deklaus/OpenValveControl/Hardware/README.md

# This folder contains the schematics and hardware description

<table>
<tr>
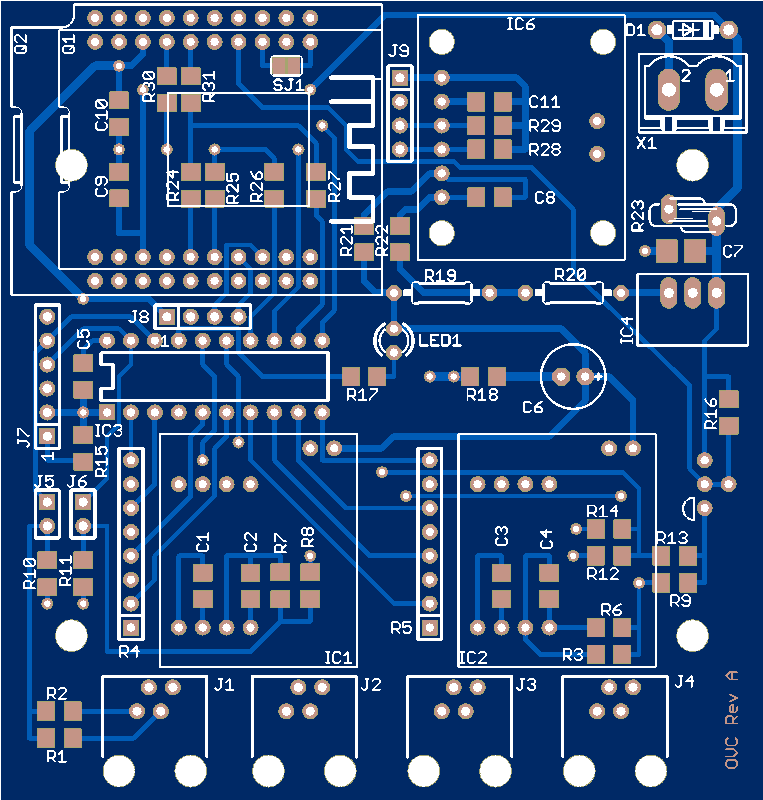
[picture p6: Hardware/ovc-A_preview_top.png]
PCB preview
  <td></td>
  <td>Assembly-2 Modules installed</td>
</tr>  
</table>

- [x] A working sample is running using a breadboard.
- [x] Layout and Gerber files are available.
- [x] PCBs available, built into housing, first desktop tests have passed.
- [x] Testing under real conditions (in progress).

## Block diagram
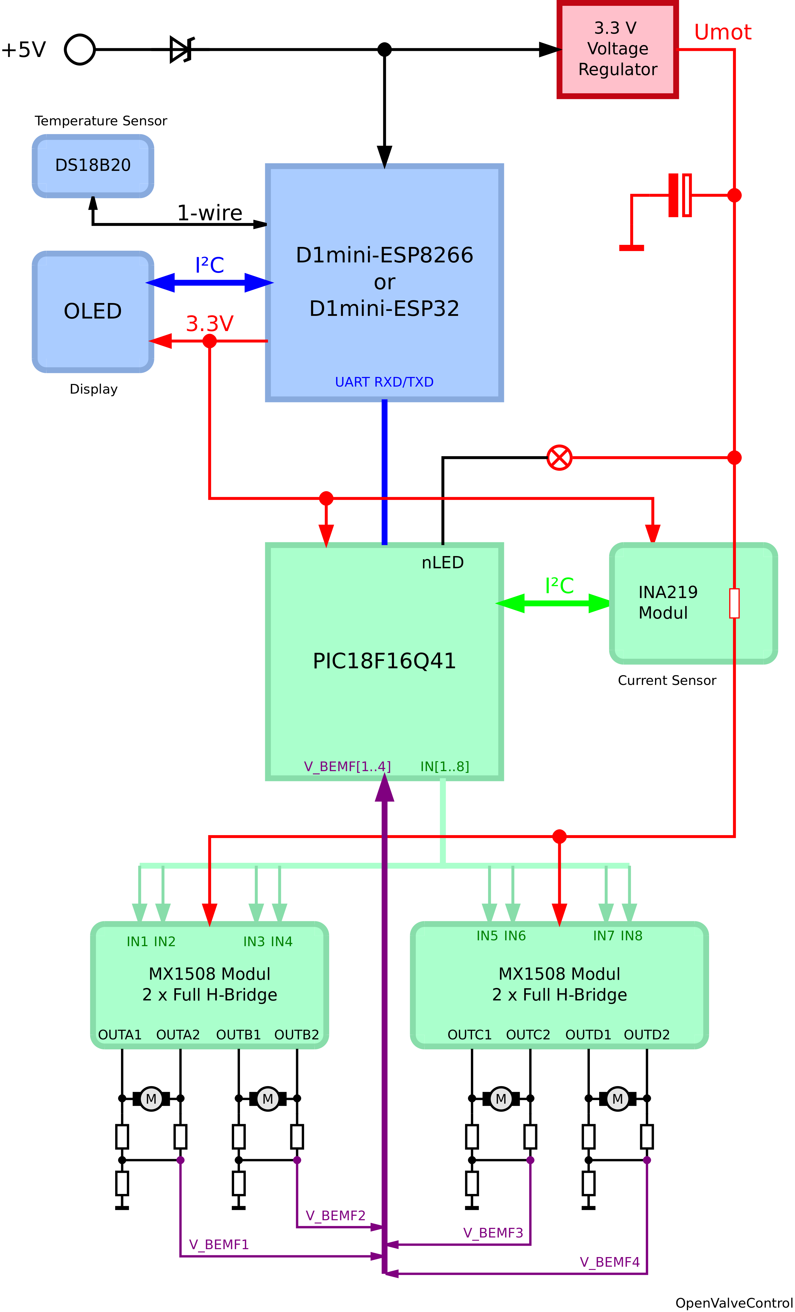
[picture p7: Photos/Block-Diagram.png]
Block-Diagram


## Schematics
- Schematics added as PDF

## Board and housing
- PCB design added as PDF
- PCB preview added
