deklaus/OpenValveControl/PIC-ValveControl/ValveControl.X/doxygen/html/init_8h_a348d23d5899ce59d18975284dfb0afc0_cgraph.png

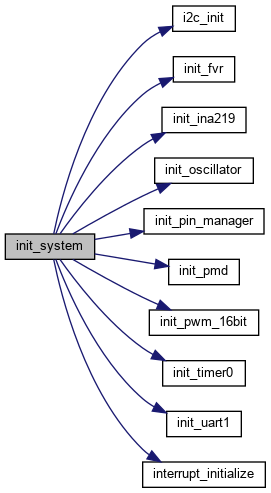
PIC-ValveControl/ValveControl.X/doxygen/html/init_8h_a348d23d5899ce59d18975284dfb0afc0_cgraph.png
