deklaus/OpenValveControl/Hardware/OpenValveControl_RevA_Schematics.pdf

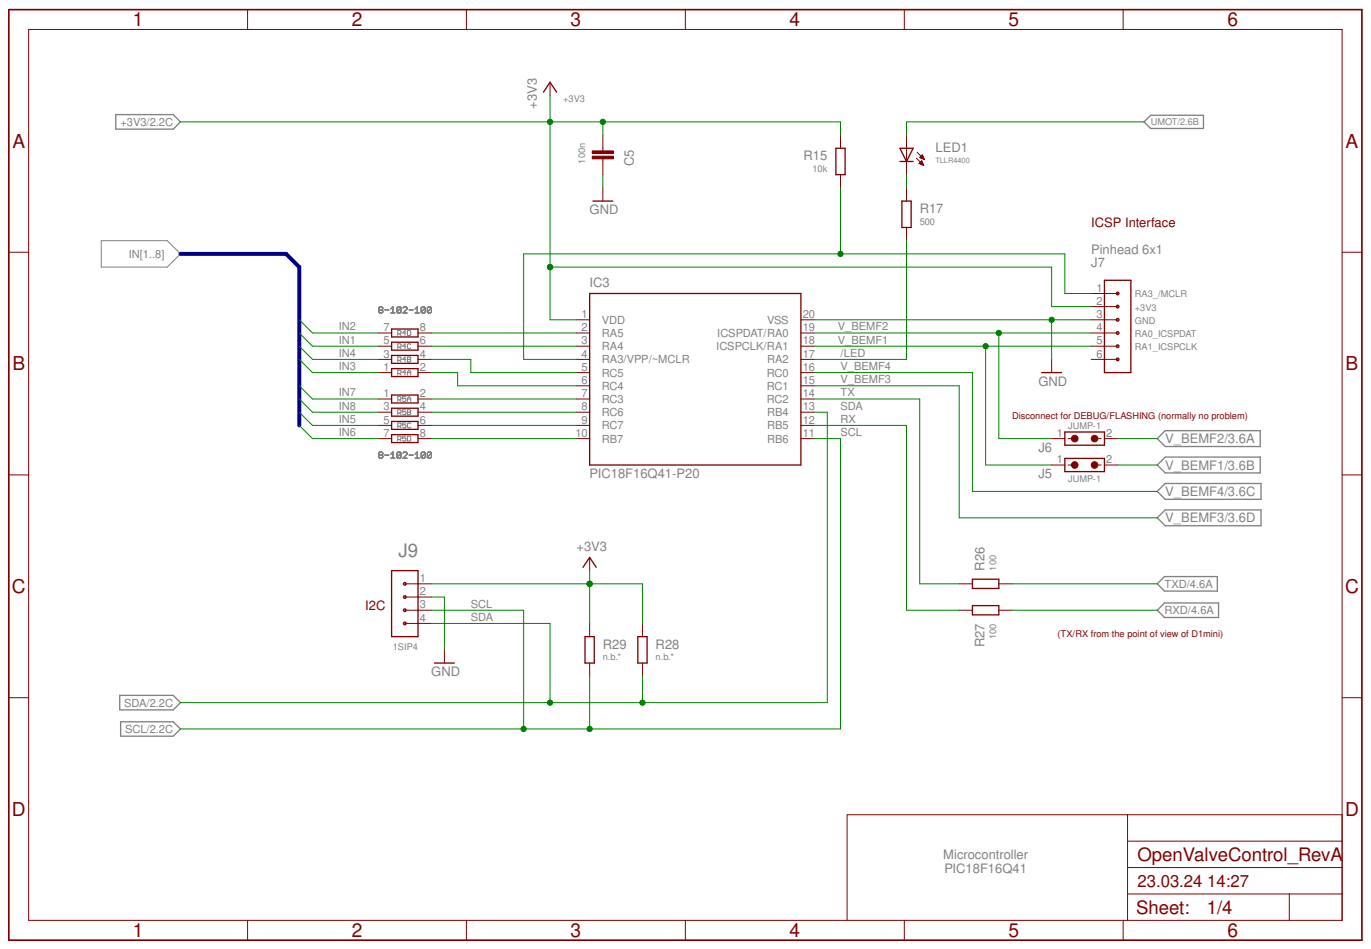
[picture p64: page 1]

Disconnect for DEBUG/FLASHING (normally no problem)

(TX/RX from the point of view of D1mini)

Microcontroller PIC18F16Q41

Sheet: 1/4

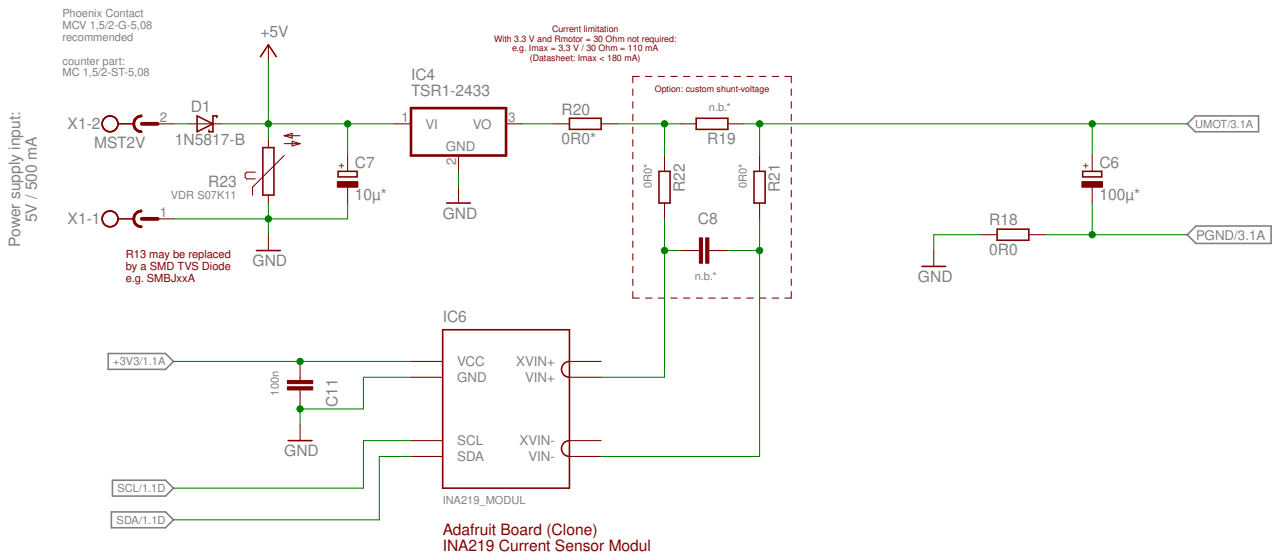
[picture p65: page 2]

Current limitation With 3.3 V and Rmotor = 30 Ohm not required: e.g. Imax = 3,3 V / 30 Ohm = 110 mA

counter part: MC 1,5/2-ST-5,08

Option: custom shunt-voltage

R13 may be replaced
by a SMD TVS Diode
e.g. SMBJxxA

Power Supply + Current Sense Modul INA219

Sheet: 2/4

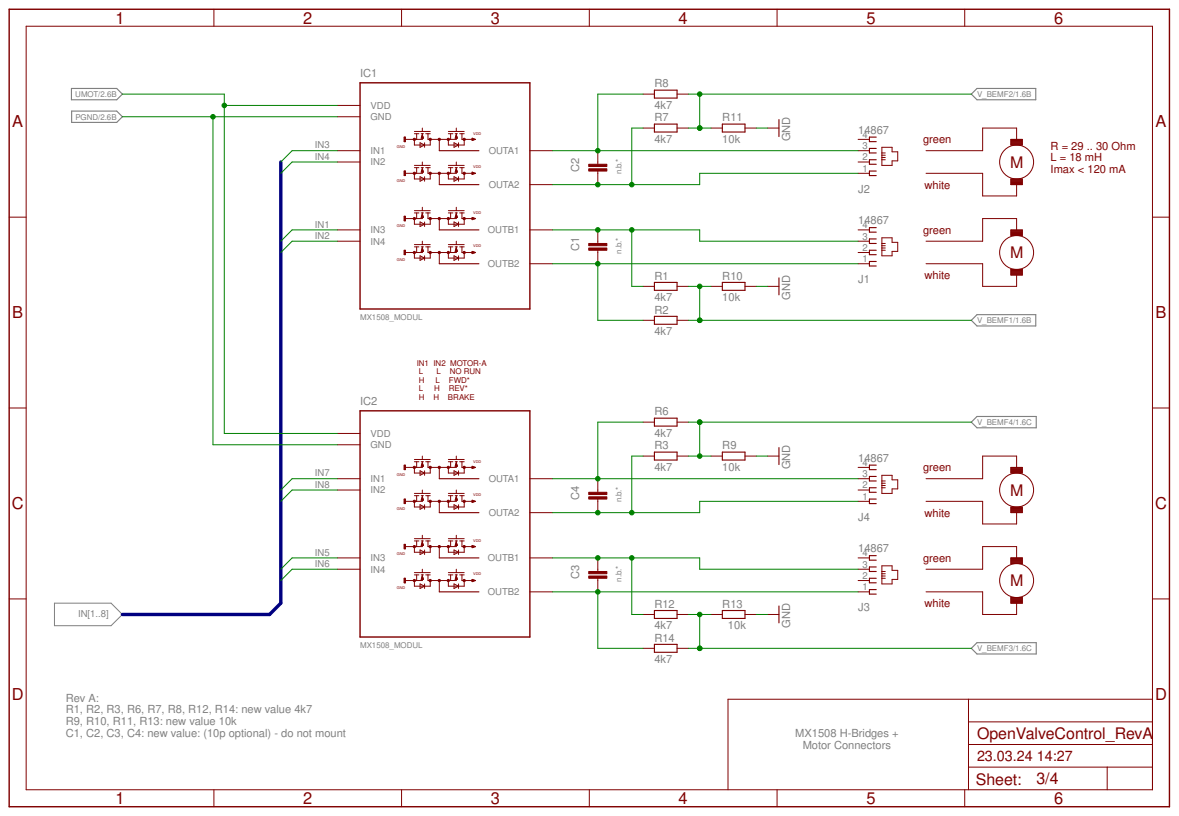
[picture p66: page 3]

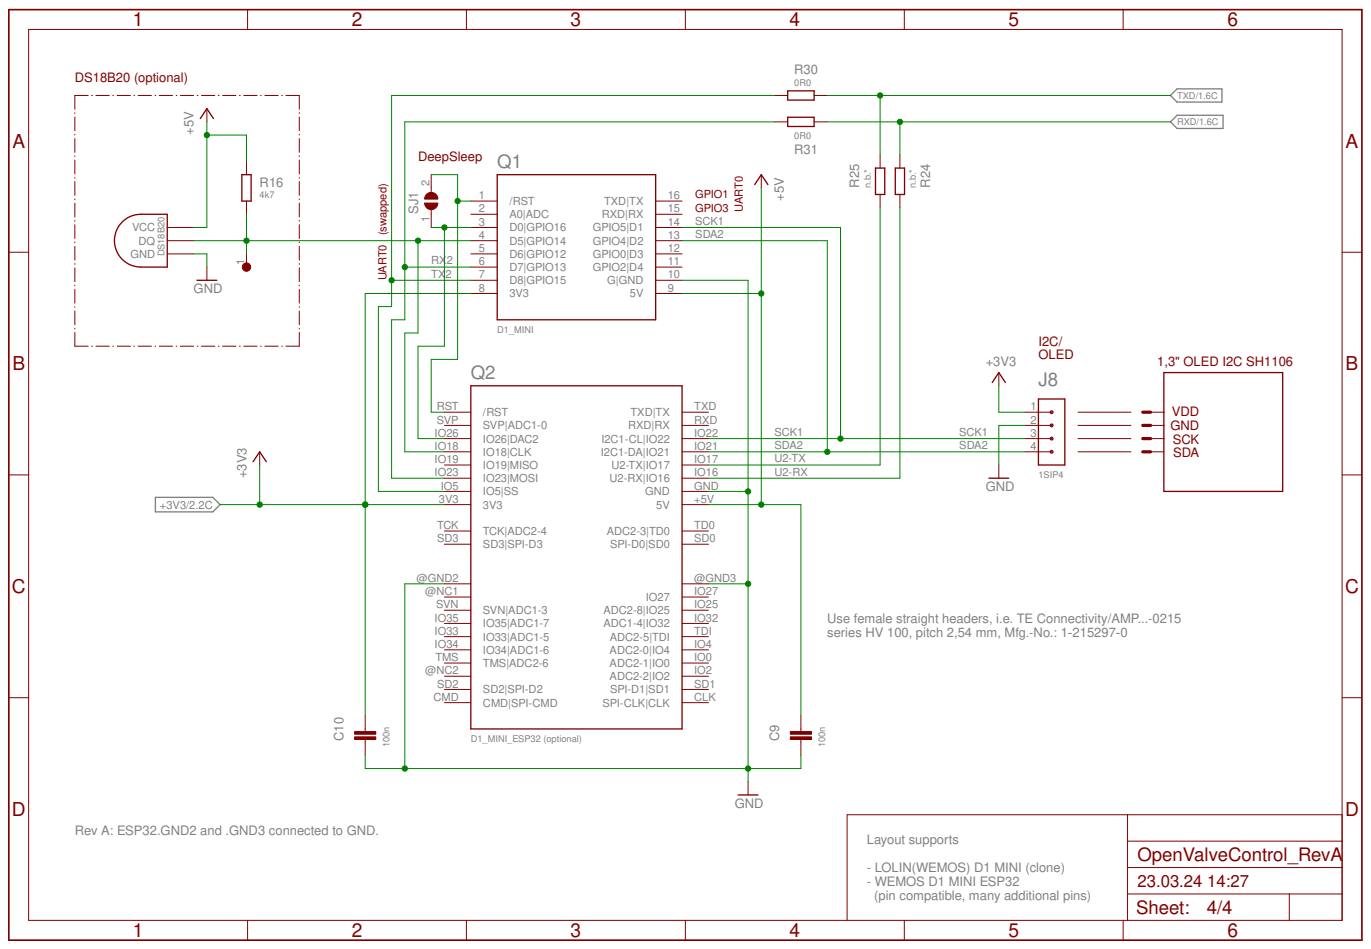
[picture p67: page 4]

7 | | 10 GPIO2|D4
8 | | 9 G|GND

Use female straight headers, i.e. TE Connectivity/AMP...-0215
series HV 100, pitch 2,54 mm, Mfg.-No.: 1‑215297‑0

Rev A: ESP32.GND2 and .GND3 connected to GND.

Layout supports - LOLIN(WEMOS) D1 MINI (clone) - WEMOS D1 MINI ESP32 (pin compatible, many additional pins)

Sheet: 4/4
