deklaus/OpenValveControl/Hardware/OpenValveControl_RevA_Board.pdf

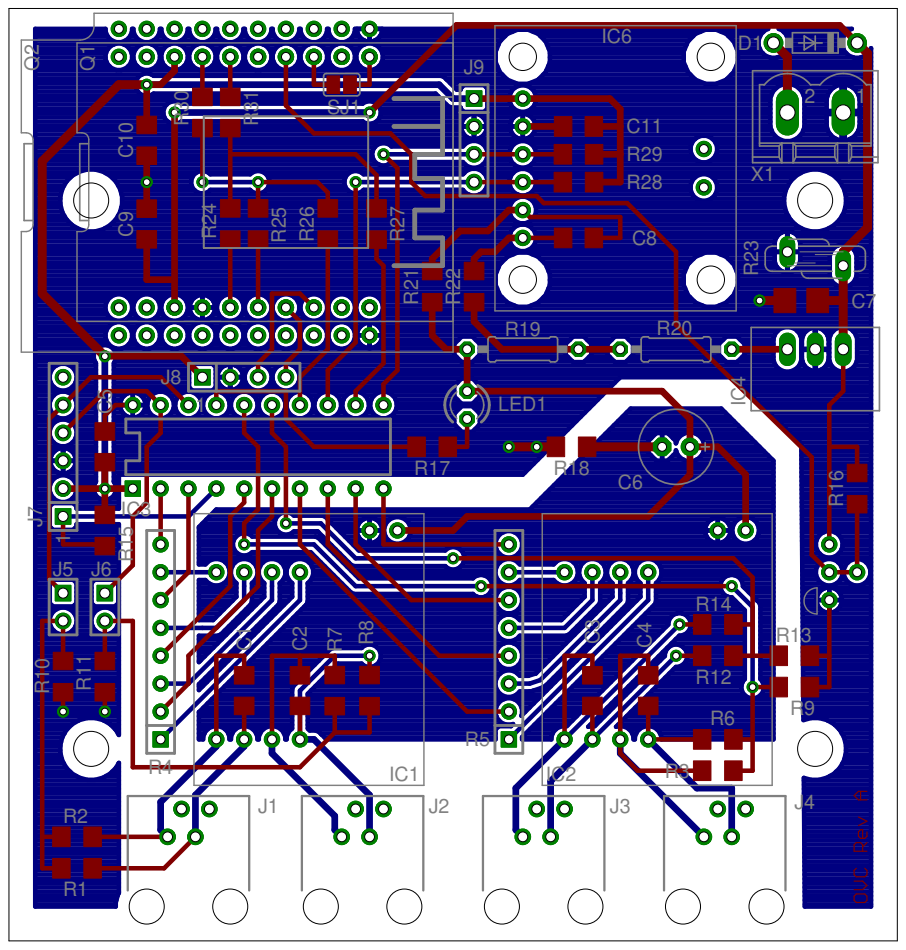
[picture p68: page 1]

C11
R29
R28 | X1
