deklaus/OpenValveControl/Hardware/OpenValveControl_RevA_Placeplan.pdf

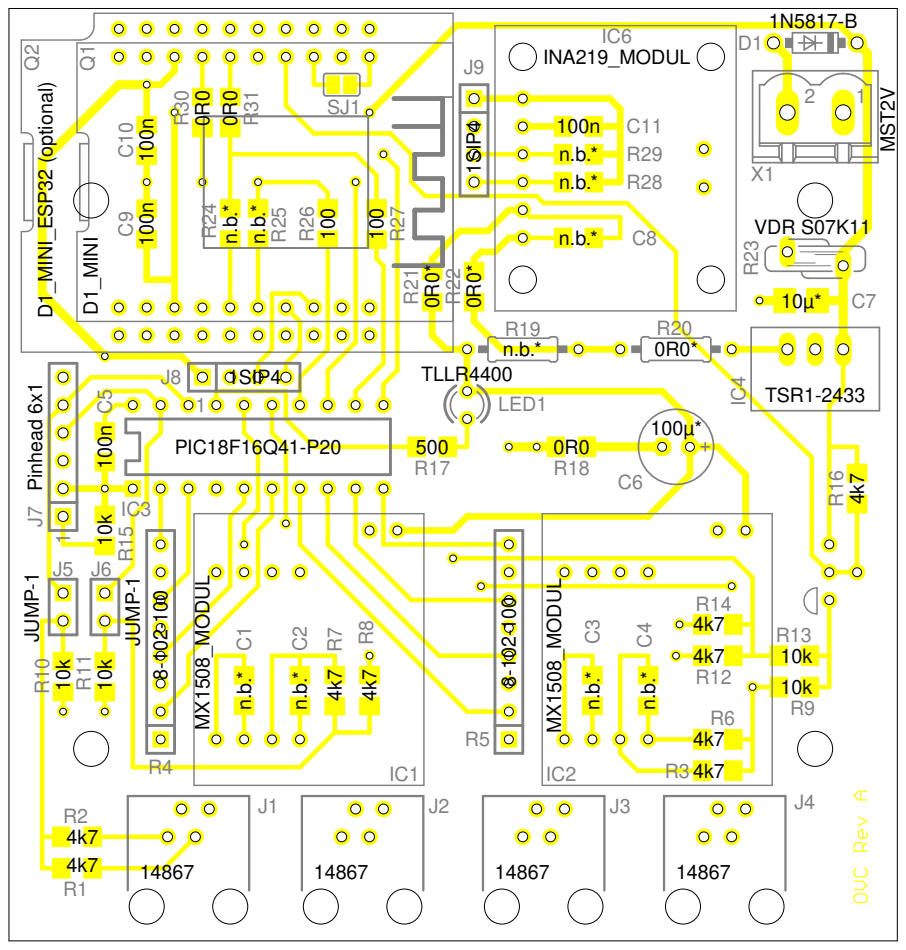
[picture p69: page 1]
