deklaus/OpenValveControl/ESP-ValveControl/ESP-ValveControl.ino

/** @file   ESPValveControl.ino
 *  @author  (c) Klaus Deutschkämer (https://github.com/deklaus)
 *  License: This software is licensed under the European Union Public Licence EUPL-1.2
 *           (see https://joinup.ec.europa.eu/collection/eupl/eupl-text-eupl-12 for details).
 *
 *  @brief  WiFi-Interface for OpenValveControl (PIC-)Controller.
 *  \b Functions:
 *   - Display all 4 valve positions
 *   - Display motor current
 *   - Selection of a distribution zone (VZ)
 *   - Input of max. current for MOVE or HOME
 *   - Triggering a MOVE (VZ) to desired position
 *   - Triggering a reference run (HOME)
 *   - Temperature measurement with DS18B20
 *   - Status display, p.e. positions, firmware (ESP and PIC), WiFi,...
 *   - Access point (until local WiFi has been configured)
 *   - OTA Firmware-Update ESP
 *   - Write to PIC EEPROM via Web UI
 *   - Firmware-Update (PIC) via Web UI
 *
 *  \b IDE: <c> Arduino IDE 2.2.1 &rarr; <c> esptool.py v3.0 \n
 *  \b Device: \n
 *     - <c> LOLIN(WEMOS) D1  mini (clone) </c> (current state)
 *     - <c> <b> WEMOS D1 mini ESP32 <\b></c>   (optional) \n
 *  \b Libs: \n
 *     - <c> ESP8266WiFi              Version 1.0     path: ~/.arduino15/packages/esp8266/hardware/esp8266/3.1.2/libraries/ESP8266WiFi </c>
 *     - <c> ESP8266WebServer         Version 1.0     path: ~/.arduino15/packages/esp8266/hardware/esp8266/3.1.2/libraries/ESP8266WebServer </c>
 *     - <c> ESP8266HTTPUpdateServer  Version 1.0     path: ~/.arduino15/packages/esp8266/hardware/esp8266/3.1.2/libraries/ESP8266HTTPUpdateServer </c>
 *     - <c> PubSubClient             Version 2.8     path: ~/Arduino/libraries/PubSubClient </c>
 *     - <c> ArduinoJson              Version 6.21.4  path: ~/Arduino/libraries/ArduinoJson </c>
 *     - <c> LittleFS                 Version 0.1.0   path: ~/.arduino15/packages/esp8266/hardware/esp8266/3.1.2/libraries/LittleFS </c>
 *     - <c> DallasTemperature        Version 3.9.0   path: ~/Arduino/libraries/DallasTemperature </c>
 *     - <c> MAX31850 OneWire         Version 1.1.3   path: ~/Arduino/libraries/MAX31850_OneWire </c>
 *     - <c> U8g2                     Version 2.34.22 path: ~/Arduino/libraries/U8g2 </c> or
 *     - <c> SPI                      Version 1.0     path: ~/.arduino15/packages/esp8266/hardware/esp8266/3.1.2/libraries/SPI </c>
 *     - <c> Wire                     Version 1.0     path: ~/.arduino15/packages/esp8266/hardware/esp8266/3.1.2/libraries/Wire </c>
 *  \n
 *  Weblinks: \n
 *  Doxygen:    https://www.doxygen.nl/manual/docblocks.html \n
 * 
 * Change Log:
 * 2024-09-24 v0.9
 * - Added new command: EEwrite EEwrite:<uint16 addr,uint16 data>
 *   This command allows to change PIC EEPROM, p.e. VBSUM_1pct @EEPROM addr = 2. 
 * - Error codes PICerrno and ESPerrno are exported with status report and are shown in Web-UI v0.9 and above.
 *   Corresponding text messages may be edited in customize.js.
 * - Read access to all files except index.html was restricted to private IP addresses Class C (192.168.x.x).
 * 2024-03-11 v0.8
 * - Added data logger: <IP>/logdata? reads curr_log[] and bemf_log[] from PIC.
 * - Added VBsum to "info?" for testing BEMF sum-up for position control.
 * 2024-01-29 v0.7.1
 * - Processing of flags.version moved to the end of "else-if". (A failed bootload could not be 
 *   repeated, because the initialized "flags.version" always took priority and never was worked off.
 * 2024-01-24 v0.7
 * - Added 'MQTT publish' with status information (motor current, temperature, positions, etc.)
 * - Added WiFI signal strength to "Info"
 *   omitted double quotes around integers and floats in JSON output.
 * - added script customize.js:
 *    This script must be uploaded into the ESP filesystem with the given name. 
 *    The function CustomizeLabels() optionally replaces some default headers 
 *    and labels by your own texts, which can be changed in the script.
 *    The script is read at the end of <head>, but the function must 
 *    only be called once at the end of <body>, when the complete HTML document 
 *    has been read by the browser.
 *    The main advantage is that your room descriptors are retained even if the 
 *    original index.html is updated.
 *    The script also can be extended by your own instructions.
 * 2023-12-01 v0.6.1
 * - Status now reflects status from PIC (set_pos[], max_mA[] and refset[]).
 * 2023-11-15 v0.6
 * - Added acces point mode (OVC-access-point/PVC-password).
 * - Reading and writing of setup file "ovc.ini". LittleFS.ini supplemented with proper mime/ContentType.
 * v0.5 Test version
 * 2023-11-12 v0.4
 * - Added OTA support. Enter URI/update to select and upload new firmware binary file (.bin).
 * 2023-11-07 v0.3
 * - Added LittleFS. Web-UI must now be uploaded as separate file (index.html) via LittleFS (URI/fs.html)
 *   Requires Web-UI (index.html) v0.3 or newer.
 * 2023-11-02 v0.2
 * - Added reading of DS18B20 and added temperature in webUI_status and webUI_info.
 *
 * @todo - poor handling of refset[] (maybe by PIC?). 
 *       - home drive sometimes doesn't reset position.
 */

// *** includes
#include <ESP8266WiFi.h>
#include <ESP8266WebServer.h>
#include <ESP8266HTTPUpdateServer.h>
#include <PubSubClient.h>
//#include <WiFiClient.h>
#include <ArduinoJson.h>
#include <LittleFS.h>

// *** function prototypes
extern int    cmd2pic (void);
extern void   create_jStatus (char *dest, int len, bool pretty);

extern void   DS18B20_init (void);
extern float  DS18B20_TempC (uint8_t index);

extern int    fw_download (char *rec);

extern void   webUI_bootload (void);
extern void   webUI_eewrite (void);
extern void   webUI_home (void);
extern void   webUI_info (void);
extern void   webUI_move (void);
extern void   webUI_notFound (void);
//extern void   webUI_root (void);
extern void   webUI_save (void);
extern void   webUI_status (void);

extern void   OLED_init (void);
extern void   OLED_show (unsigned row, char *s);
extern void   OLED_update_status (void);

extern void   setupFS ();

extern int    setup_GetCstring (const char *path, const char *identifier, char *result, int Nmax);
extern int    setup_GetInt (const char *path, const char *identifier, int *result);
extern int    setup_GetFloat (const char *path, const char *identifier, float *result);
extern int    setup_ReadINI (const char *path);
extern int    setup_WriteCstring (const char *path, const char *identifier, char *s);

// *** private function prototypes
extern void   getPIClogdata (void);
extern void   getPICversion (void);

// *** data type, constant and macro definitions
//#define DEBUG_OUTPUT_DS1820   1   /* enable serial monitor: status DS18B20 */
//#define DEBUG_OUTPUT_STATUS   1   /* enable serial monitor: status read from PIC */
//#define DEBUG_OUTPUT_WIFI     1   /* enable serial monitor: WIFI status after connect */
//#define DEBUG_OUTPUT_INI      1   /* enable serial monitor: INI file functions */
//#define DEBUG_MQTT_PUBLISH    1   /* enable serial monitor: MQTT publish */

#define numVZ   4             // no. of available Valve Zones / motors

#define CYCLE_TIME    500   /* cycle time of main loop */
#define MAX_ACK_TIME  500   /* timeout in milliseconds for command acknowledge from PIC */

// bitfields are not really the optimum - a boolean flag_move, flag_home, ... might be the better choice!?
struct FLAGS  //!<   flags to start tasks within loop()
{
  uint8_t move     :1;  //!< 0 exec move
  uint8_t home     :1;  //!< 1 exec home
  uint8_t status   :1;  //!< 2 exec status
  uint8_t save     :1;  //!< 3 exec save
  uint8_t bootload :1;  //!< 4 update PIC firmware
  uint8_t version  :1;  //!< 5 update PIC version
  uint8_t logdata  :1;  //!< 6 reads log data from PIC
  uint8_t eewrite  :1;  //!< 7 write to PIC EEPROM
  uint8_t          :1;  //!< 8 
}; 

/* uint16_t status word (read from PIC)
 * Bit definitions/macros are more safe than structs, when using different compilers)
 */
#define REF(x)    (x & 0x000F)
#define REF1(x)   (x & 0x0001)
#define REF2(x)   (x & 0x0002)
#define REF3(x)   (x & 0x0004)
#define REF4(x)   (x & 0x0008)
#define VZ(x)    ((x & 0x00F0) >> 4)    /* 'vz' of active command as bit pattern: which motor is moving/homing? */
#define VZ1(x)   ((x & 0x0010) >> 4)    /* 1: vz1 is under process */
#define VZ2(x)   ((x & 0x0020) >> 5)    /* 1: vz2 is under process */
#define VZ3(x)   ((x & 0x0040) >> 6)    /* 1: vz3 is under process */
#define VZ4(x)   ((x & 0x0080) >> 7)    /* 1: vz4 is under process */
#define MOVE(x)  ((x & 0x0100)          /* 'move' is executing */
#define HOME(x)  ((x & 0x0200)          /* 'home' is executing */


enum Errs {     /* ALL PIC errnos are negative, ESP errors are positive  */
    E_ADC_TIMEOUT          = -127,   // AD converter timeout

    E_EEWR_ARGC            = -9,     // EEPROM write: argument count != 2
    E_EEWR_ADDR            = -8,     // EEPROM write: address out of range
    E_HOMEING_ACTIVE       = -7,     // Move command, whereas Home is active
    E_MOVE_ARGC            = -6,     // Move command: argument count != 3
    E_NO_REFERENCE         = -5,     // Reference not set
    E_UNDEF_CMD            = -4,     // Undefined command
    E_MA_MAX               = -3,     // Out of range: mA_max
    E_SET_POS_RANGE        = -2,     // Out of range: set_pos
    E_VZ_RANGE             = -1,     // Out of range: vz

    E_NO_ERR               =  0,     // No error

    E_INIFILE_NOT_FOUND    =  1,     // INI file not found
    E_IDENTIFIER_NOT_FOUND =  2,     // Identifier not found
    E_PIC_TIMEOUT          =  3,     // PIC timeout
    E_NACK_Move            =  4,     // Move not acknowledged by PIC
    E_NACK_Home            =  5,     // Home not acknowledged by PIC
    E_NACK_Status          =  6,     // Status not acknowledged by PIC
    E_NACK_EEwrite         =  7,     // EEPROM write not acknowledged by PIC
    E_ADDR_RANGE           =  8,     // (EEPROM write) address out of range
    E_EEWRITE_ARGC         =  9,     // (EEPROM write) argument count != 2
    E_DATA_RANGE           = 10,     // (EEPROM write) data out of range
};



/** LIBRARY INSTANCES */

/** Webserver
 *  ========= */
ESP8266WebServer server(80);
ESP8266HTTPUpdateServer httpUpdater;


/** MQTT client (publisher only)
 *  ===========
 */
WiFiClient    espClient;
PubSubClient  MQTTclient(espClient);

/** Global variables
 *  =============== */
char  ESPversion[32] = "v0.9";   // Version of ESP-Firmware
char  PICversion[32] = "NN";     // Version of PIC-Firmware

// WiFi credentials: Initial values are used for access point!
// The credential aof your routers WiFi can be customized in "ovc.ini" (uploaded into LittleFS)
char  ssid[64] = "OVC-access-point";  // SSID (access point)
char  psk[64]  = "OVC-password";      // Password (access point)
long  rssi;                           // signal strength in dBm

IPAddress remoteIP;                   // the client's (remote) IP
int16_t   ESPerrno = 0;               // ESP errno

// MQTT
char  mqtt_host[64] = "";   // IP address of mqtt host (broker)
char  mqtt_prefix[64] = ""; // prefix (p.e. "OVC-1")
char  mqtt_token[64] = "";  // token for publish (p.e. "OVC-1/tempC" etc.)

char  jStatus[512];         // set big enough to hold the "beautyfied" JSON status!
unsigned long mqttLastConnect = millis();
unsigned long mqttLastPub = millis();
unsigned long mqttCurrentTime;
unsigned long mqttPeriod = 900000;  // default: 15 minutes

char  alias1[8];    // aliases for "VZ1" to "VZ4"
char  alias2[8];
char  alias3[8];
char  alias4[8];

// Vars sourced by PIC µC
uint16_t  status;         // status word from PIC
int16_t   PICerrno = 0;   // errno returned from PIC (cmd2pic)
float     mAmps = 0.0;    // actual current [mA]
float     tempC = 0.0;    // temperature in Celsius (DS18B20)
float     dTemp = 0.0;    // temperature adjust (ovc.ini)
int       position[numVZ + 1] = {-1, 0, 65, 36, 100 };        // actual VZ positions (index 0 is dummy)
bool      refset[numVZ + 1];                                  // home position set?
int       vbemf_sum[numVZ + 1];

// Vars sourced by (html) User Interface 
struct FLAGS  flags;      // processing flags (Web UI -> loop)
int       vz = 0;         // selected valve zone (motor), [1 .. 4], 0 = none!
int       set_pos[numVZ + 1]  = { -1, 0, 65, 36, 100 };       // valve set positions
float     max_mA[numVZ + 1]   = { 0.0, 30.0, 30.0, 30.0, 30.0 };  // motor current limits [mA]
int       EEaddr;   // address for EEPROM write
int       EEdata;   // data for EEPROM write

char      txbuf[64];
char      rxbuf[64];
char      hexfilename[64];
int       nrx;        // number of received chars in rxbuf

unsigned long TimeStamp = 0;        /* used for general delay purposes (local)  */


/** @brief ESP8266 Initialization
 *  @todo Implement access point (AP) mode to enter WiFi Credentials.
 */
void setup ()
{
  int    error;
  String param;

  /** - Initialize Serial (UART0) to 38400 Bd. \n
   *    Serial uses UART0 which is mapped to pins GPIO1 (TX/pin22) and GPIO3 (RX/pin21).  
   *    For communication with the PIC µC, we remap UART0 to GPIO15 (TX': D8/pin16) and GPIO13 (RX': D7/pin7) by Serial.swap(). 
   *    Calling swap again maps UART0 back to GPIO1 and GPIO3. (Serial1/UART1 can not be used to receive).
   *    Weblink: https://esp8266-arduino.readthedocs.io/en/latest/reference.html "Serial".
   */
  Serial.begin(38400);
  Serial.swap();  // disconnect serial console on ESP8266 and swap connection to PIC µC

  /** - Initialize OLED Status Display \n
   *    Show local IP address and initial valve positions.
   */
  OLED_init();

#ifdef SHOW_SKETCH_SPACE
// TEST: show sketch size and free sketch space in OLED
  float sketchSize = (float)ESP.getSketchSize();
  float freeSketchSpace = (float)ESP.getFreeSketchSpace();
  snprintf(txbuf, 21, "size: %.0f", sketchSize); 
  OLED_show(0, txbuf);
  snprintf(txbuf, 21, "free: %.0f", freeSketchSpace); 
  OLED_show(1, txbuf);
#endif

  /** - Initialize temperature sensor DS18B20 */
  DS18B20_init();

  /** - Setup Little FileSystem
   *    Also configures the server for filesystem operations (format, upload, ...) */
  setupFS();

  /* Read setup data from LittleFS.
   * Weblinks: https://arduino-esp8266.readthedocs.io/en/latest/filesystem.html
   *           https://randomnerdtutorials.com/esp32-write-data-littlefs-arduino/#esp32-save-variable-littlefs
   * Also reads the WiFi credentials (if uploaded to /ovc.ini)   */
  error = setup_ReadINI("/ovc.ini");

  /** - Initialize WiFi  
        Weblink: https://arduino-esp8266.readthedocs.io/en/latest/esp8266wifi/generic-class.html
   */
  OLED_show(0, ssid);
  if (0 == strcmp(ssid, "OVC-access-point"))  // default ssid (no setup by ovc.ini)
  { // create access point
    WiFi.mode(WIFI_AP);
    if (WiFi.softAP(ssid, psk)) OLED_show(1, psk);     // AP setup okay
    else                        OLED_show(1, (char *)"Error");
  }
  else
  { // try: connect to router with credentials from ovc.ini
    WiFi.mode(WIFI_STA);
    WiFi.begin(ssid, psk);
    for (int timeout = 0; (WiFi.status() != WL_CONNECTED) &&  (timeout < 120); timeout++)
    { // Wait for WiFi connection, cancel after 2 minutes.
      OLED_show(0, (char *)" ");
      delay(500);
      OLED_show(0, ssid);
      delay(500);
    }
  }

  if (WiFi.status() == WL_CONNECTED)
  {
    // Show local IP address on OLED, so we can connect to the webserver UI
    // (one OLED row is max. 21 chars wide)
    snprintf(txbuf, 21, "IP: %s", WiFi.localIP().toString().c_str()); 
    OLED_show(0, txbuf);
  }
  else { // if connection failed, use accesspoint to make corrections
    strcpy(ssid, "OVC-access-point"); // reset
    strcpy(psk,  "OVC-password");
    WiFi.mode(WIFI_AP);
    OLED_show(0, ssid);
    if (WiFi.softAP(ssid, psk)) OLED_show(1, psk);     // AP setup okay
    else                        OLED_show(1, (char *)"Error");
  }

  if (WiFi.getMode() == WIFI_AP)
  { // default IP address of AP is 192.168.4.1 and may be changed using softAPConfig, see:
    // https://arduino-esp8266.readthedocs.io/en/latest/esp8266wifi/soft-access-point-class.html#softapip
    delay(5000);  // 5 sec for reading the credentials, then show IP
    snprintf(txbuf, 21, "IP: %s", WiFi.softAPIP().toString().c_str()); 
    OLED_show(0, txbuf);
  }

#ifdef DEBUG_OUTPUT_WIFI
  Serial.flush();   // Wait for the transmission of outgoing serial data to complete
  Serial.swap();    // map UART0 to serial monitor
  Serial.println("");
  Serial.print("Connected:  ");
  Serial.println(ssid);
  Serial.print("IP address: ");
  Serial.println(WiFi.localIP());
  Serial.print("PSK: ");
  Serial.println(psk);      // security risc!
  //Serial.println("****"); // optional
  Serial.flush();   // Waits for the transmission of outgoing serial data to complete
  Serial.swap();    // remap output to PIC
#endif

  flags.version = 1;  // try to read (new) PIC firmware version

  /** - Setup Webserver for ESP ValveControl
   *  This implements our client request handlers. You can append the GET commands and parameters to the URI, e.g.
   *  http://192.168.2.75/move?vz=1&set_pos=25&max_mA=30   move selected valve to 25 % position.
   *  http://192.168.2.75/home?vz=3&max_mA=45              request homing of the selected valve.
   *  http://192.168.2.75/status                           get status information (current, temperature, valve states)
   *  http://192.168.2.75/info                             get system information (Firmware releases, WiFi SSID)
   */
// server.on("/", handleRoot);  // handled by LittleFS -> invokes /index.html (our Web UI)
  server.on("/bootload", HTTP_GET, webUI_bootload);
  server.on("/eewrite",  HTTP_GET, webUI_eewrite);
  server.on("/move",     HTTP_GET, webUI_move);
  server.on("/home",     HTTP_GET, webUI_home);
  server.on("/logdata",  HTTP_GET, webUI_logdata);
  server.on("/info",     HTTP_GET, webUI_info);
  server.on("/status",   HTTP_GET, webUI_status);
  server.on("/save",     HTTP_GET, webUI_save);
  //server.on("/format");  // handled by LittleFS
  //server.on("/upload");  // handled by LittleFS
  //server.onNotFound(webUI_notFound);  // already handled by LittleFS

  /** - Setup OTA httpUpdater
        Weblink:  https://arduino-esp8266.readthedocs.io/en/latest/ota_updates/readme.html#web-browser
  */
  httpUpdater.setup(&server);
  server.begin();

  if (strlen(mqtt_host) > 6)
  {
    MQTTclient.setServer(mqtt_host, 1883);  // default port for MQTT is 1883
    MQTTclient.setBufferSize(512);    // The maximum message size, including header (default is 256 bytes)
  }

} // setup()



/** @brief  ESP8266 main loop
 *  - Process request handler and execute commands from UI
 *  - Periodically read status from PIC (valve controller)
 *  - Update OLED status display
*/
void loop ()
{
  unsigned long LoopStamp = millis();   // used to run main loop with constant execution time
  int       error;
  int       ival32;
  uint16_t  uval;
  char      buf[64];
  char      *p;

  if (flags.move)       // MOVE command?
  {
   /* Send MOVE command regardless of reference points and other conditions - errors must be handled by PIC.
    * Due to long execution time, the PIC µC acknowledges only reception of the command.
    */    
    sprintf(txbuf, "Move:%d,%d,%d", vz, set_pos[vz], (uint16_t)(10 * max_mA[vz]));      // Move:vz:set_pos[vz]:10 x max_mA[vz]
    OLED_show(1, txbuf);    // optional show on OLED.row 1 (0..5)
    delay(500);    
    error = cmd2pic();
    // check if response contains command token ("Move"), else it is an error reponse
    if (strncmp(rxbuf, "Move:", 5) != 0)  // compare first N chars of response with command
    { /** @todo optional error handler, response might contain error number */
      error = E_NACK_Move;
    }
    flags.move = 0;
  } // if flags.move

  else if (flags.home)       // HOME command?
  {
   /* Send HOME command regardless of reference points and other conditions - errors must be handled by PIC.
    * Due to long execution time, the PIC µC acknowledges only reception of the command.
    */    
    sprintf(txbuf, "Home:%d,%d", vz, (uint16_t)(10 * max_mA[vz]));      // Home:vz:10 x max_mA[vz]
    OLED_show(1, txbuf);    // optional show on OLED.row 1 (0..5)
    delay(500);    
    error = cmd2pic();
    if (strncmp(rxbuf, "Home:", 5) != 0)  // compare first N chars of response with command
    { /** @todo optional error handler, response might contain error number */
      error = E_NACK_Home; 
    }
    flags.home = 0;
  }

  else if (flags.save)       // SAVE & REBOOT?
  {
    flags.save = 0;
    setup_WriteCstring((char *)"/ovc.ini", "SSID", ssid);
    setup_WriteCstring((char *)"/ovc.ini", "PSK",  psk);

    // reboot
    OLED_show(0, (char *)"reBOOT-please wait..");
    server.send(200, "text/html", "Restart_Ok");
    delay(500);
    ESP.restart();
  }

  else if (flags.bootload)       // Update PIC firmware
  {
    fw_download();
    for (int i = 0; i < 4; i++) 
    { // wait for PIC reboot
      server.handleClient();
      delay(500);    
    }
    flags.bootload = 0;
  }

  else if (flags.eewrite)       // EEPROM write?
  {
    sprintf(txbuf, "EEwrite:%u,%u", EEaddr, EEdata);      // EEwrite:EEaddr,EEdata
    OLED_show(1, txbuf);    // optional show on OLED.row 1 (0..5)
    delay(500);    
    error = cmd2pic();
    // check if response contains command token ("Move"), else it is an error reponse
    if (strncmp(rxbuf, "EEwrite:", 8) != 0)  // compare first N chars of response with command
    { /** @todo optional error handler, response might contain error number */
      error = E_NACK_EEwrite;
    }
    flags.eewrite = 0;
  } // if flags.eewrite

  else if (flags.logdata)       // read logdata (curr_log[], bemf_log[]) from PIC
  {
    getPIClogdata();
    flags.logdata = 0;
  }

  else if (flags.version)       // Update PIC version info
  {
    getPICversion();
  }


  /* Repeatedly process request handler until mid of loop cycle   */
  do
  {
    server.handleClient();  // mandatory
  } while ((millis() - LoopStamp) < CYCLE_TIME/2);


  /* Read status from PIC, result format: "Status:Pos1,Pos2,Pos3,Pos4,mAx10,0xstatus"  */
  sprintf(txbuf, "Status?");
  error = cmd2pic();
  // check if response contains command token ("Status:"), else it is an error reponse
  if (strncmp(rxbuf, "Status:", 7) != 0)  // compare first N chars of response with command
  { /// @todo optional error handler, response might contain error number
    error = E_NACK_Status; 
  }

  /* Process status or error message  */
  if (error)
  {
    /// @todo add appropriate error handler
#ifdef DEBUG_OUTPUT_STATUS
    Serial.flush();   // Waits for the transmission of outgoing serial data to complete
    Serial.swap();    // output to serial monitor
    Serial.println(rxbuf);
    Serial.flush();   // Waits for the transmission of outgoing serial data to complete
                      // (prior to Arduino 1.0, this instead removed any buffered incoming serial data)
    Serial.swap();    // output to PIC µC
#endif
  }
  else
  { // find separator, then convert values
    p = strstr(rxbuf, ":");
    for (int i = 1; i <= 4; i++)
    {
      if (p)    // positions[1..4]
      {
        uval = atoi(++p);
        if (uval <= 100) position[i] = uval;
        p = strstr(p, ",");
      }
    }
    if (p) {    // mAmps
      uval = atoi(++p);
      if (uval <= 500) mAmps = (float) uval / 10.;
      p = strstr(p, ",");
    }
    if (p)      // status word
    {
      if (sscanf(++p, "0x%04x", &uval) == 1) 
      {
        status = uval;
        refset[1] = REF1(status) ? 1 : 0;
        refset[2] = REF2(status) ? 1 : 0;
        refset[3] = REF3(status) ? 1 : 0;
        refset[4] = REF4(status) ? 1 : 0;
        p = strstr(p, ",");
      } 
    }
    if (p)      // status word
    {
      if (sscanf(++p, "0x%08x", &ival32) == 1) 
      {
        vbemf_sum[1] = ival32;
        // p = strstr(p, ",");
      } 
      else vbemf_sum[1] = -1;
    }
    else vbemf_sum[1] = -2;



#ifdef DEBUG_OUTPUT_STATUS
      Serial.flush();   // Waits for the transmission of outgoing serial data to complete
      Serial.swap();    // output to serial monitor
      Serial.print("Positions: ");
      for (int i=1; i <= 4; i++) {    Serial.print(position[i]); Serial.print(","); }
      sprintf(buf, "%.1f,", mAmps);   Serial.print(buf);
      sprintf(buf, "0x%04X", status); Serial.println(buf);
      Serial.flush();   // Waits for the transmission of outgoing serial data to complete
                        // (prior to Arduino 1.0, this instead removed any buffered incoming serial data)
      Serial.swap();    // output to PIC µC
#endif

    /* read temperature sensor (index 0), usually the heating flow temperature.  */
    tempC = DS18B20_TempC(0) + dTemp;

    /* update OLED position display */
    OLED_update_status();
  }

  /* Repeatedly process request handler until end of loop cycle */
  do  
  {
    server.handleClient();  // mandatory
  } while ((millis() - LoopStamp) < CYCLE_TIME);


  /* MQTT: send data every xx seconds to broker. re-connect if connection is lost 
   * Weblinks: 
   * https://arduinojson.org/v5/assistant/
   * https://arduinojson.org/v6/api/jsondocument/
   * https://arduinojson.org/v6/how-to/reuse-a-json-document/
   * https://arduinojson.org/v6/doc/serialization/
   * https://arduinojson.org/v6/example/
   * https://circuits4you.com/2019/01/11/nodemcu-esp8266-arduino-json-parsing-example/
   */
  mqttCurrentTime = millis();
  if ((strlen(mqtt_host) > 6) && (WiFi.status() == WL_CONNECTED))
  { // MQTT has been configured && WiFi is connected
    if (MQTTclient.connected())
    { // publish every mqttPeriod
      if ((mqttCurrentTime - mqttLastPub) > mqttPeriod)
      {
        sprintf(mqtt_token, "%s/status", mqtt_prefix);
        create_jStatus (jStatus, sizeof(jStatus), false);   // create minified JSON document
        MQTTclient.publish(mqtt_token, jStatus);
        mqttLastPub = mqttCurrentTime;

#ifdef DEBUG_MQTT_PUBLISH
        Serial.flush();
        Serial.swap();
        Serial.println(jStatus);
        Serial.flush();
        Serial.swap();
#endif
      }
    } // if MQTT connected
    else if ((mqttCurrentTime - mqttLastConnect) > (unsigned long) 30000)
    { // try to (re-)connect every 30 s
      MQTTclient.connect(mqtt_token);
      mqttLastConnect = mqttCurrentTime;
    }
  } // if MQTT has been configured && WiFi is connected

} // loop()


/** @brief This function creates the const char jStatus[] which can be used 
 *  by the webUI (/status) or published to the MQTT server.
 *  jStatus has the following JSON structure:
 *  { 
 *  "mAmps": "0.1",
 *  "tempC": "24.4",
 *  "VZ1": { "Position": 10, "Set_Pos": 0, "Ref_Set": 1, "max_mA": 50.0 },
 *  "VZ2": { "Position": 20, "Set_Pos": 0, "Ref_Set": 0, "max_mA": 50.0 },
 *  "VZ3": { "Position": 30, "Set_Pos": 0, "Ref_Set": 1, "max_mA": 50.0 },
 *  "VZ4": { "Position": 40, "Set_Pos": 0, "Ref_Set": 1, "max_mA": 50.0 }
 *  }
 *  @param  char *dest[len]  Result char array with minimum size len
 *  @note Adjust <capacity> when changes are required (see https://arduinojson.org/v6/assistant/).
*/
void create_jStatus (char *dest, int len, bool pretty)
{
  StaticJsonDocument<384> doc;  // recommended size for serializing 

  doc["mAmps"] = round(mAmps * 10) / 10.0;
  doc["tempC"] = round(tempC * 10) / 10.0;
  doc["PICerrno"] = PICerrno;
  doc["ESPerrno"] = ESPerrno;

  JsonObject VZ1 = doc.createNestedObject("VZ1");
  VZ1["Position"] = position[1];
  VZ1["Set_Pos"] = set_pos[1];
  VZ1["Ref_Set"] = refset[1] ? 1 : 0;
  VZ1["max_mA"] = max_mA[1];

  JsonObject VZ2 = doc.createNestedObject("VZ2");
  VZ2["Position"] = position[2];
  VZ2["Set_Pos"] = set_pos[2];
  VZ2["Ref_Set"] = refset[2] ? 1 : 0;
  VZ2["max_mA"] = max_mA[2];

  JsonObject VZ3 = doc.createNestedObject("VZ3");
  VZ3["Position"] = position[3];
  VZ3["Set_Pos"] = set_pos[3];
  VZ3["Ref_Set"] = refset[3] ? 1 : 0;
  VZ3["max_mA"] = max_mA[3];

  JsonObject VZ4 = doc.createNestedObject("VZ4");
  VZ4["Position"] = position[4];
  VZ4["Set_Pos"] = set_pos[4];
  VZ4["Ref_Set"] = refset[4] ? 1 : 0;
  VZ4["max_mA"] = max_mA[4];

  if (pretty) serializeJsonPretty(doc, dest, len);
  else        serializeJson(doc, dest, len);

} // create_jStatus ()


/** @brief  This function sends the command string in txbuf[] via UART to the PIC µC 
 *          and waits for a response or timeout. 
 *          The response is returned in global rxbuf[].
 *  @return int error  0: no error
 *                    -1: timeout
*/
int cmd2pic (void)
{
  unsigned long tstart;
  String  str;   
  int     error = 0;
  bool    eol;
  char    c;

  // flush response buffer 
  while (Serial.available() > 0) Serial.read();   // clean up serial input
  eol = 0;
  nrx = 0;
  rxbuf[0] = '\0';  // flush rxbuf

  Serial.println(txbuf);  // transmit query to PIC µC
  tstart = millis();

  // wait for eol := command ack (reception only, not yet execution)
  for (error = 0; !eol && !error;  )
  {
    while (Serial.available() > 0 && !eol) 
    {
      c = Serial.read();
      if (c == '\r') continue;  // skip
      if (c == '\n') 
      {
        if (nrx < 2)  continue;
        eol = true;
        c = '\0';
      }
      if (nrx < sizeof(rxbuf))  // if not buffer overflow
      {
        rxbuf[nrx++] = c;       // store received char in rxbuf, increment count
      }
      else rxbuf[sizeof(rxbuf) - 1] = '\0'; // terminate rxbuf
    } // while

    if ((millis() - tstart) > MAX_ACK_TIME)
    {
      error = E_PIC_TIMEOUT;
/*
      Serial.flush();   // Waits for the transmission of outgoing serial data to complete
      Serial.swap();    // output to serial monitor
      Serial.println("cmd2pic: MAX_ACKTIME exceeded");
      Serial.flush();   // Waits for the transmission of outgoing serial data to complete
      Serial.swap();    // output to PIC µC      
*/
    }
    server.handleClient();      // process WebUI during wait
  } // for

  if (eol)  // we got a response
  { 
    str = String(rxbuf);
    if (str.startsWith("ERROR"))
    {
      error = str.substring(5).toInt();
      PICerrno = error;
    }
    else if (!str.startsWith("Status:")) PICerrno = 0;

    /** @todo response could contain an error mesg - how to handle this?)
      TEST: * /
      Serial.flush();   // Waits for the transmission of outgoing serial data to complete
      Serial.swap();    // output to serial monitor

      Serial.print ("> ");
      Serial.println(txbuf);  // copy output to serial monitor

      Serial.print ("< ");
      Serial.println(rxbuf);
      Serial.flush();   // Waits for the transmission of outgoing serial data to complete
      Serial.swap();    // output to PIC µC
    */
  } // if
  else  // no response (timeout)
  { 
    error = E_PIC_TIMEOUT;
/*
    Serial.flush();   // Waits for the transmission of outgoing serial data to complete
    Serial.swap();    // output to serial monitor
    Serial.print (txbuf);
    Serial.println(": Timeout");  // copy output to serial monitor
    Serial.flush();   // Waits for the transmission of outgoing serial data to complete
    Serial.swap();    // output to PIC µC
*/    
    /** @todo show err mesg in LCD (and WebUI? / status?) */
  } // else

  return (error);

} // cmd2pic


/** @brief Read PIC Firmware Version and save in 'PICversion'
*/
void getPICversion (void)
{
  int error;

  sprintf(txbuf, "Version?");
  error = cmd2pic();
  if (!error && (strncmp(rxbuf, "Version:", 8) == 0))  // compare first N chars of response with command
  { 
    strncpy(PICversion, &rxbuf[9], sizeof(PICversion));
    PICversion[sizeof(PICversion) - 1] = '\0';
    flags.version = 0;
  }

} // getPICversion()


/** @brief Read LogData from PIC and save in LittleFS as file 'logdata.csv'
*/
void getPIClogdata (void)
{
  unsigned long tstart;
  File logfile;
  String  str;   
  int     error = 0;
  bool    eol;
  char    c;

  logfile = LittleFS.open("logdata.csv", "w");
  if(logfile)
  {
    while (Serial.available() > 0) Serial.read();   // flush serial
    
    sprintf(txbuf, "LogData?"); // send request to PIC
    error = cmd2pic();
    if (!error && (strncmp(rxbuf, "LogData:", 8) == 0))  // compare first N chars of response
    { 
      do 
      {
        rxbuf[0] = '\0';  // flush rxbuf
        nrx = 0;
        eol = 0;
        tstart = millis();
        for (error = 0; !eol && !error;  )
        {
          while (Serial.available() > 0 && !eol) 
          {
            c = Serial.read();
            if (c == '\r') continue;  // skip
            if (c == '\n') 
            {
              if (nrx < 2)  continue;
              eol = true;
              c = '\0';
            }
            if (nrx < sizeof(rxbuf))  // if not buffer overflow
            {
              rxbuf[nrx++] = c;       // store received char in rxbuf, increment count
            }
            else rxbuf[sizeof(rxbuf) - 1] = '\0'; // terminate rxbuf
          } // while

          if ((millis() - tstart) > MAX_ACK_TIME)
          {
            error = E_PIC_TIMEOUT;
          }
          server.handleClient();      // process WebUI during reception
        } // for

        if (eol)  // we received a record
        { 
          logfile.println(rxbuf);
          // logfile.writeString(rxbuf);
        }
        server.handleClient();  // mandatory
      } while (!error); // read until timeout, don't use fix limit
      OLED_show(1, (char *)"Logfile complete!");
    }
    logfile.print("Error: ");
    logfile.println(error);
    logfile.close();
  }
  else 
  {
    OLED_show(1, (char *)"Can't create logfile");
  }

} // getPIClogdata()
