deklaus/OpenValveControl/PIC-ValveControl/ValveControl.X/init.c

/** @file   init.c
 *  @brief  Initialization functions 
 *  @par  (c) 2023-2024 Klaus Deutschkämer
 *  License: EUROPEAN UNION PUBLIC LICENCE v. 1.2 \n
 *  see https://joinup.ec.europa.eu/collection/eupl/eupl-text-eupl-12
 */
/* Change Log:
 * 2024-10-04 v0.9
 * - Experimental: VBSUM_1pct is the sum of Vbemf for a 1 % travel. This 
 *   constant may be preset in EEPROM and it is read during initialization from 
 *   EEPROM addr 02/03 (little endian).
 *   When in range, positions are calculated from g_vbemf_sum (sum of Vbemf, 
 *   which is supposed to be an estimation of speed): 
 *      g_position[i] = g_vbemf_sum[i] / VBSUM_1pct;
 *   When out of range, positions are calculated from time of travel: 
 *      g_position[*] += g_dir*;
 * 2024-04-18 v0.8.2
 * - PWM2 slice2 P2 falling edge invokes the interrupt to read the back EMF.
 *   By this, the ISR doesn't contain any delay at all further more.
 * - PWM2 module has to be enabled in PMD (Peripheral Module Disable).
 * 2024-01-20 v0.7
 * - PWM is now generated by the 16 bit PWM module (CCP pwm was hogging TMR2).
 *   PWM1 slice1 P1out is used to drive the H-bridges, its right edge is used
 *   to read VBEMF in the PWM isr.
 *   PWM1 slice1 P2 (right edge, ca. 2 ms after H-bridge ON) now invokes the 
 *   PWM isr to read the motor current. This eliminates the annoying 2 ms delay 
 *   within the obsolete IOC_ISR, which was causing missed ESP commands).
 * 2023-10-17 V0.1
 * - Initial issue
 * @test
 * @bug
 */


// Configuration bits: selected in the code configurator GUI (see mcc.c)
// pragma config statements should precede project file includes.
// CONFIG1
#pragma config FEXTOSC = OFF            // External Oscillator Selection
#pragma config RSTOSC = HFINTOSC_64MHZ  // Reset Oscillator Selection

// CONFIG2
#pragma config CLKOUTEN = OFF   // CLKOUT function is disabled
#pragma config PR1WAY = OFF     // PRLOCKED bit can be set and cleared
#pragma config CSWEN = ON       // Clock Switch: Writing NOSC and NDIV allowed
#pragma config FCMEN = OFF      // Fail-Safe Clock Monitor disabled
#pragma config FCMENP = ON      // FSCM will flag FSCMP/OSFIF on EXTOSC failure
#pragma config FCMENS = OFF     // FSCM will not flag FSCMP/OSFIF on SOSC fail

// CONFIG3
#pragma config MCLRE = EXTMCLR  // MCLR: If LVP = 0, MCLR pin is MCLR
#pragma config PWRTS = PWRT_OFF // Power-up timer (PWRT) is disabled
#pragma config MVECEN = ON      // Multi-vector enabled, Vector table is used
#pragma config IVT1WAY = OFF    // IVTLOCKED bit can be cleared and set
#pragma config LPBOREN = ON     // Low-Power BOR enabled
#pragma config BOREN = ON       // Brown-out Reset enabled according to SBOREN

// CONFIG4
#pragma config BORV = VBOR_1P9  // Brown-out Reset Voltage Selection: 1.9 V
#pragma config ZCD = OFF        // ZCD module is disabled (at POR)
#pragma config PPS1WAY = OFF    // PPSLOCK bit can be written as needed
#pragma config STVREN = ON      // Stack full/underflow will cause Reset
#pragma config LVP = OFF        // HV on MCLR/VPP must be used for programming
#pragma config XINST = OFF      // Extended Instr. Set: Not supported by XC8

// CONFIG5
#pragma config WDTCPS = WDTCPS_31 // WDT Period -> software control
#pragma config WDTE = OFF         // WDT -> Disabled, SWDTEN is ignored

// CONFIG6
#pragma config WDTCWS = WDTCWS_7  // WDT Window -> always open (100%)
#pragma config WDTCCS = SC        // WDT input clock -> Software Control

// CONFIG7
#pragma config BBSIZE = BBSIZE_1024	// Boot Block Size -> 1024 words (0..0x07FF)
#pragma config BBEN = OFF          	// Boot Block Enable -> disabled
#pragma config SAFEN = OFF         	// SAF Enable -> SAF disabled
#pragma config DEBUG = OFF         	// Background Debugger disabled

// CONFIG8
#pragma config WRTB = OFF         // Boot Block -> NOT write protected
#pragma config WRTC = OFF         // Config Register -> NOT write protected
#pragma config WRTD = OFF         // Data EEPROM -> NOT write protected
#pragma config WRTSAF = OFF       // Storage Area Flash -> NOT write protected
#pragma config WRTAPP = OFF       // Application Block -> NOT write protected

// CONFIG9
#pragma config CP = OFF           // Code Protection (Flash and EEPROM) -> OFF


#include <xc.h>             /* XC8 General Include File */
#include "main.h"
#include "i2c.h"
#include "init.h"
#include "interrupt.h"

/* Macro to disable Bootlaoder after first flashing
 * by initializing EEPROM[0] with 0x00.
 * VBEMF_SUM_1pct is preset to 2500 = 0x61A8 (stored as little endian!) */
__EEPROM_DATA(0x00,0xFF, 0xA8,0x61, 0xFF,0xFF, 0xFF,0xFF);  

// *** data type, constant and macro definitions
// *** global variables
// *** private variables
// *** private function prototypes
// *** public function bodies

/** @brief  This is the main initialization function.
 */
void init_system (void)
{
    uint8_t u8;
    
    INTCON0bits.GIE = 0;    // Global Interrupt Disable
    
    init_oscillator();
    init_pmd();
    init_pin_manager();     // define I/Os

    init_timer0();          // TMR0: 1 ms system clock (used for timeouts etc.)    
    i2c_init();             // I2C: 400 kHz, current sensor module INA216 
    init_ina219();          // using defaults only
    
    init_fvr();             // fixed voltage reference (measure VDD)
    init_pwm_16bit();       // PWM to run the H bridge and generate interrupts
    init_uart1();

    I2C1CON0bits.EN = 1;    // enable the I2C module
    
/// - Read Device Information Area (DIA)
    NVMADR = 0x2C0032;          // @ADC FVR1 voltage for 2x setting (in mV)
    NVMCON1bits.CMD = 0b000;    // read command (PFM: word)
    NVMCON0bits.GO = 1;         // start word read
    while (NVMCON0bits.GO);     // wait for the read operation to complete
    FVRA2X = NVMDAT;            // 0x0808 = 2056 (Beispiel Eval-Board: +0,39 %)

    NVMADR = 0x2C0038;          // @CMP/DAC FVR2 voltage for 2x setting (in mV)
    NVMCON1bits.CMD = 0b000;    // read command (PFM: word)
    NVMCON0bits.GO = 1;         // start word read
    while (NVMCON0bits.GO);     // wait for the read operation to complete
    FVRC2X = NVMDAT;            // 0x0814 = 2068 (Beispiel Eval-Board: +0,98 %)    

    
    // Read VBSUM_1pct from EEPROM @0x02/03 (LB/HB)
    NVMDATL = 0x00;
    NVMADR = EEPROM_BASE + 0x03;
    NVMCON1bits.CMD = 0b000;    // read command (DFM: byte)
    NVMCON0bits.GO = 1;
    while (NVMCON0bits.GO);     // wait for the read operation to complete
    VBSUM_1pct = NVMDATL;
    VBSUM_1pct <<= 8;

    NVMADR = EEPROM_BASE + 0x02;
    NVMCON1bits.CMD = 0b000;    // read command (DFM: byte)
    NVMCON0bits.GO = 1;
    while (NVMCON0bits.GO);     // wait for the read operation to complete
    VBSUM_1pct += NVMDATL;
    
/// - Initialize Interrupts
    interrupt_initialize();  // Enable Priority Vectors, set high/low priorities
    
    // PIR4bits.U1RXIF = 0;   // U1RXIF is read only
    PIE4bits.U1RXIE = 1;      // enable RX INT
    
    interrupt_GlobalLowEnable();    // Enables low-priority INTs (if GIE is set)
    interrupt_GlobalHighEnable();   // Enables all high and low priority INTs    
    
} // init_system ()


/** @brief Init the FVR and enable the temperature indicator.
 * 
 * - Enables fixed voltage reference (FVR)
 * - Enabels temperature indicator (TI): High Range (Vout = 3VT)
 * - FVR Buffer 1 (ADC):       2x (2.048 V)
 * - FVR Buffer 2 (CMP & DAC): 2x (2.048 V)
 */
void init_fvr (void)
{
    FVRCONbits.TSRNG = 1;       // Hi range: Vout = 3VT (requires VDD >= 2.5 V)
    FVRCONbits.ADFVR = 0b10;    // ADC FVR Gain is 2x (output = 2.048 V)
    FVRCONbits.CDAFVR = 0b10;   // Comparator FVR Gain is 2x (output = 2.048 V)
    FVRCONbits.FVREN = 1;       // enabled Fixed Voltage Reference
    FVRCONbits.TSEN = 1;        // Temperature Sensor Enable

} // init_fvr ()


/** @brief Setup of the INA219 Module to measure current.
 * - The default I2C address of the INA219 is 0x40.
 * - When using the INA219 in default mode, nothing has to be initialized. 
 *   + See datasheet 8.5.3: \n
 *     <i><b>Simple Current Shunt Monitor Usage:</b> \n
 *     The INA219 can be used without any programming if it is only necessary 
 *     to read a shunt voltage drop and bus voltage with the default 12-bit 
 *     resolution, 320-mV shunt full-scale range (PGA = /8), 32-V bus full-scale 
 *     range, and continuous conversion of shunt and bus voltage. \n
 * => Without programming, current is measured by reading the shunt voltage.</i>
 * 
 * \verbatim
 * Hex Register          POR       Type
 * 00  Configuration     0x399F    R/W
 * 01  Shunt voltage     -         R
 * 02  Bus voltage       -         R
 * 03  Power             0000      R
 * 04  Current           0000      R
 * 05  Calibration       0000     R/W
 * \endverbatim
 */
void init_ina219 (void)
{
    // ina219_write(0x05, 10240);  // Calibration register (test)

} // init_ina219 ()


/** @brief Initialize sysclock as 16 MHz from internal HFINTOSC.
 */
void init_oscillator (void)
{
    // NOSC HFINTOSC; NDIV 1; 
    OSCCON1 = 0x60;
    // CSWHOLD may proceed; SOSCPWR Low power; 
    OSCCON3 = 0x00;
    // MFOEN disabled; LFOEN disabled; ADOEN disabled; PLLEN disabled; SOSCEN disabled; EXTOEN disabled; HFOEN disabled; 
    OSCEN = 0x50;
    // HFFRQ 16_MHz; 
    OSCFRQ = 0x05;
    // TUN 0; 
    OSCTUNE = 0x00;
    // ACTUD enabled; ACTEN disabled; 
    ACTCON = 0x00;
	
} // init_oscillator ()


/** @brief Initializes all ports as input/output, analog/digital, 
 *  open drain/push pull, and assign peripheral functions as needed:
 * 
 * <b>Pin assignments:</b>
 * \verbatim
 * RA5: OUT IN2
 * RA4: OUT IN1
 * RA3: INP RESET
 * RA2: OUT /LED
 * RA1: AIN V_BEMF1
 * RA0: AIN V_BEMF2
 * 
 * RB7: OUT IN6
 * RB6: OUT SCL
 * RB5: OUT RXD (esp pov)
 * RB4: I/O SDA
 * 
 * RC7: OUT IN5
 * RC6: OUT IN8
 * RC5: OUT IN4
 * RC4: OUT IN3
 * RC3: OUT IN7
 * RC2: INP TXD (esp pov)
 * RC1: AIN V_BEMF3
 * RC0: AIN V_BEMF4
 * \endverbatim
 */
void init_pin_manager (void)
{
    // LATx registers
    LATA = 0x04;        // RA2 = /LED
    LATB = 0x00;
    LATC = 0x00;

    // ANSELx registers
    ANSELA = 0x03;      // RA0/1 : VBEMF2/1
    ANSELB = 0x00;
    ANSELC = 0x03;      // RC0/1 : VBEMF4/3

    // WPUx registers
    WPUA = 0x00;
    WPUB = 0x00;
    WPUC = 0x00;

    // ODx registers
    ODCONA = 0x00;
    ODCONB = 0b01010000;    // SDA and SCL must be configured as open-drain
    ODCONC = 0x00;

    // TRISx registers (RXD/TXD from PIC's point of view)
    TRISA = 0b00001011;     // RA4/5 = IN1/IN2, RA2 = /LED, RA0/1 = VBEMF2/1
    TRISB = 0b00000000;     // RB6 = SCL1, RB5 = TXD, RB4 = SDA1
    TRISC = 0b00000011;     // RC2 = RXD, RC0/1 = VBEMF4/3
    
    // SLRCONx registers (0 = max Slew Rate, 1 = limited Slew Rate)
    SLRCONA = 0xFF;         // default after Reset: 1
    SLRCONB = 0xFF;
    SLRCONC = 0xFF;

    // INLVLx registers (0 = TTL input, 1 = ST input)
    INLVLA = 0xFF;         // default after Reset: 1
    INLVLB = 0xFF;
    INLVLC = 0xFF;
    
	// I2C Pins
    I2C1SDAPPS = 014;   // RB4->I2C1:SDA1;  octal
    RB4PPS = 0x22;      // RB4->I2C1:SDA1;    
    I2C1SCLPPS = 016;   // RB6->I2C1:SCL1;  octal
    RB6PPS = 0x21;      // RB6->I2C1:SCL1;    

    LATBbits.LATB4 = 1; // TRIS RB4 = SDA1
    LATBbits.LATB6 = 1; // TRIS RB6 = SCL1       
    
	// we don't use PWM inputs, keep the defaults
    PWMIN1PPS = 0x13;   // RC3->PWM1_16BIT:PWMIN1
    PWMIN0PPS = 0x15;   // RC5->PWM1_16BIT:PWMIN0

} // init_pin_manager())



/** @brief Init the PMD (Peripheral Module Disable).
    - Disabling the not required peripheral modules reduces power consumption.
*/
void init_pmd (void)
{
    PMD0 = 0b00111010;  // Disable FOSC, FVR, HLVD, CRC, SCAN, -, CLKR, IOC
    PMD1 = 0b00111000;  // Disable CMP1, ZCD, SMT1, TMR4/TMR3/TMR2/-/TMR0
    PMD2 = 0b01100001;  // Disable CCP1, CWG1, DSM1, NCO1, ACT, DAC1, ADC, CMP2?
    PMD3 = 0b00110100;  // Disable UART2/1, SPI2/1, I2C1, PWM3/2/1
    PMD4 = 0b11111111;  // Disable DMA3/2/2, CLC4/4/2/1, UART3,
    PMD5 = 0b00000111;  // Disable OPA1, DAC2, DMA4    
} // init_pmd ()


/** Init the PWM (125 Hz).
 *  - Left aligned mode \n
 *  - PWM 1 Slice 1 P1: 90% duty cycle (7.2 ms + 0.8 ms = 8 ms) \n
 *    This slice's High level enables the H-bridge (when PWM1P1out is applied).
 *  - PWM 1 Slice 1 P2: 25% duty cycle (2.0 ms + 6.0 ms = 8 ms) \n
 *    The falling edge generates the interrupt to read the motor current.
 * 
 *  - PWM 2 Slice 1 P2: 95% duty cycle (7.6 ms + 0.4 ms = 8 ms) \n
 *    The falling edge generates the interrupt to read the Back EMF voltage.
 * 
 *  see datasheet ch. 30.
*/
void init_pwm_16bit (void)
{
   
/*  PWM 1 */
    PWM1CON = 0x00;     // disable PWM1, set defaults
    
    PWM1ERS = 0x00;     // PWMERS External Reset Disabled (default) 
    PWM1CLK = 0x02;     // PWMCLK FOSC
    PWM1LDS = 0x00;     // PWMLDS Autoload disabled (default)
    
    // Period = (PR+1)/FOSC = 0x7CFF / 4 MHz = 8 ms
    PWM1PRL = 0xFF;     // PWMPRL 255 (Period Register LB)
    PWM1PRH = 0x7C;     // PWMPRH 124 (Period Register HB)

    PWM1CPRE = 0x03;    // PWMCPRE No clock prescale (n+1)
    PWM1PIPOS = 0x00;   // PWMPIPOS No interrupt postscale (default)
    PWM1GIR = 0x00;     // clear interrupt flags
    
    PWM1GIE = 0x00;     // Slice 1 Parameter 1/2 match interrupt disabled
    PWM1S1CFG = 0x00;   // Slice 1 Left aligned mode (default)  

    // PWM1 Slice 1 Parameter 1 (= Active Period in Left Aligned Mode).
    // PWM1_S1P1_out is high n PWM1 clock periods at beginning of PWM1 period:
    // 0x7080 / 4 MHz = 7,2 ms
    PWM1S1P1L = 0x80;
    PWM1S1P1H = 0x70;

    // PWM1 Slice 1 Parameter 2 (= Active Period in Left Aligned Mode).
    // PWM1_S1P2_out is high n PWM1 clock periods at beginning of PWM1 period:
    // 0x1F40 / 4 MHz = 2 ms (25% duty cycle)
    PWM1S1P2L = 0x40;
    PWM1S1P2H = 0x1F;
    
    PIE4bits.PWM1IE = 0;    // PWM1_16BIT parameter interrupt enable bit
    PIE4bits.PWM1PIE = 0;   // PWM1_16BIT period interrupt enable bit
    PIR4bits.PWM1PIF = 0;   // Clear PWM1_16BIT period interrupt flag
    PWM1GIEbits.S1P2IE = 1; // enable PWM1 Param2 int (right edge)
    

/*  PWM 2 */
    PWM2CON = 0x00;     // disable PWM2, set defaults
    
    PWM2ERS = 0x00;     // PWMERS External Reset Disabled (default) 
    PWM2CLK = 0x02;     // PWMCLK FOSC
    PWM2LDS = 0x00;     // PWMLDS Autoload disabled (default)
    
    // Period = (PR+1)/FOSC = 0x7CFF / 4 MHz = 8 ms
    PWM2PRL = 0xFF;     // PWMPRL 255 (Period Register LB)
    PWM2PRH = 0x7C;     // PWMPRH 124 (Period Register HB)

    PWM2CPRE = 0x03;    // PWMCPRE No clock prescale (n+1)
    PWM2PIPOS = 0x00;   // PWMPIPOS No interrupt postscale (default)
    PWM2GIR = 0x00;     // clear interrupt flags
    
    PWM2GIE = 0x00;     // Slice 'a' Parameter 1/2 match interrupt disabled
    PWM2S1CFG = 0x00;   // Slice 'a' Left aligned mode (default)  

    // PWM2 Slice 1 Parameter 1 (= Active Period in Left Aligned Mode).
    // PWM2_S1P1_out is high n PWM1 clock periods at beginning of PWM1 period:
    // 0x7080 / 4 MHz = 7,2 ms
    PWM2S1P1L = 0x80;
    PWM2S1P1H = 0x70;
    
    // PWM2 Slice 1 Parameter 2 (= Active Period in Left Aligned Mode).
    // PWM2_S1P2_out is high n PWM2 clock periods at beginning of PWM2 period:
    // 0x76C0 / 4 MHz = 7,6 ms
    PWM2S1P2L = 0xC0;
    PWM2S1P2H = 0x76;

    PIE5bits.PWM2IE = 0;    // PWM2_16BIT parameter interrupt enable bit
    PIE5bits.PWM2PIE = 0;   // PWM1_16BIT period interrupt enable bit
    PWM2GIEbits.S1P2IE = 1; /* enable PWM2 Param2 int (right edge) */ \
  
    // Setting the EN bits in the PWMEN register enables PWM1 and PWM2 
    // simultaneously to synchronize both PWMs instead of PWMxCONbits.EN = 1;
    PWMEN = 0x03;
    
} // init_pwm_16bit ()


/** @brief Initializes Timer 0 to generate an interrupt every 1 ms.
 *         The TMR0 ISR increments the global variable (uint16_t) g_timer_ms.
 */
void 
init_timer0 (void) 
{
    T0CON0 = 0;     // TMR0 disable
    T0CON1 = 0x54;  // T0CS FOSC/4; T0CKPS 1:16; T0ASYNC not_synchronised
    TMR0H = 249;    // Match every TMR0H+1 clocks -> 1 ms
    TMR0L = 0;
    PIR3bits.TMR0IF = 0;    // clear interrupt flag bit
    PIE3bits.TMR0IE = 1;    // TMR0 Interrupt Enable
    T0CON0bits.EN = 1;      // T0EN enabled; T0OUTPS 1:1; T016BIT 8-bit; 
    
} // init_timer0 ()


/** @brief Initializes UART1 for communication with the ESP8266 D1-mini.
 *  - RXD = RC2     RXD/TXD from PIC's point of view
 *  - TxD = RB5
 *  - 38400 Bd, 8 bit, 1 stop
 *  - receive interrupts enabled
 */
void 
init_uart1 (void) 
{
    TRISCbits.TRISC2 = 1;
    ANSELCbits.ANSELC2 = 0;
    
    // configure receiver
    U1CON1bits.ON = 0;      // Serial port disabled (held in Reset)
    
    U1BRG =  25;            // ~38400 Baud  (@16 MHz: U1BRG = 1e6/Baud - 1)
    // Baudrate normal speed, no auto bd, TX enabled, RX enabled, 8 bit ASYNC
    U1CON0 = 0b00110000;
    
    U1CON2 = 0;
    U1CON2bits.RXPOL = 0;   // RX polarity is not inverted, Idle state is high
    U1CON2bits.TXPOL = 0;   // TX polarity is not inverted, Idle state is high
    U1RXPPS = 0b010010;     // UART1 Receive  on pin RC2
    RB5PPS = 0x10;          // UART1 Transmit on Pin RB5
    
    U1CON1bits.ON = 1;      // serial port enabled

} // init_uart1 ()


// *** private function bodies


/**
 End of File
 */
