deklaus/OpenValveControl/PIC-ValveControl/ValveControl.X/interrupt.c

/** @file   interrupt.c
 *  @brief  Implementations of vectored interrupts (PIC18F..)
 *  @par  (c) 2023-2024 Klaus Deutschkämer
 *  License: EUROPEAN UNION PUBLIC LICENCE v. 1.2 \n
 *  see https://joinup.ec.europa.eu/collection/eupl/eupl-text-eupl-12
 */
/*  ChangeLog:
 * 2024-04-18 v0.8.2
 * - Added PWM2 high priority parameter interrupt to read the back EMF voltage.
 * 2024-03-12 v0.8
 * - Added logdata bemf_log[1024] and curr_log[1024], which can be read by ESP.
 * - Added experimental g_vbemf_sum (integral of speed * dt ~ distance?)
 * 2024-01-20 v0.7
 * - PWM is now generated by the 16 bit PWM module (CCP pwm was hogging TMR2).
 *   PWM1 slice1 P1out is used to drive the H-bridges, its right edge is used
 *   to read VBEMF in the PWM isr.
 *   PWM1 slice1 P2 (right edge, ca. 2 ms after H-bridge ON) now invokes the 
 *   PWM isr to read the motor current. This eliminates the annoying 2 ms delay 
 *   within the obsolete IOC_ISR, which was causing missed ESP commands).
 * 2023-10-17 V0.1
 * - Initial issue
 */

// *** includes
#include <xc.h>
#include "main.h"
#include "daq.h"
#include "init.h"
#include "i2c.h"

// *** data type, constant and macro definitions

#define IVT1_BASE_ADDRESS   0x0808      /* required with bootloader */
//#define IVT1_BASE_ADDRESS   0x0008

//#define USE_mAMP_LoPASS     1
//#define USE_BEMF_LoPASS     1

#define NLoPASS_BEMF        1
#define NLoPASS_CURR        1
/*  Low Pass Filter
    y(k) = a * u(k) + b * y(k-1);       b = 1 - a;
    y(k) = a * u(k) + y(k-1) - a * y(k-1);
A very fast implementation of 'a * u(k)' and '- b * y(k-1)' simply shifts 
the values u(k) and y(k-1) by NLoPASS bit to the right. This results in:
NLoPASS  1       2       3       4       5
a:      1/2     1/4     1/8     1/16    1/32    = (1 >> NLoPASS)
Ts/T:	1.44	3.48	7.49	15.5	31.5    Time Constant / Sample Interval
*/

// *** global variables
// *** private variables
// *** private function prototypes
// *** public function bodies

/** @brief Vectored Interrupt Manager. \n
 The interrupt sources are placed to high and low priorities:
\verbatim
 High Priority Interrupt |  Low Priority Interrupt \n
 Vector |     Source     |  Vector  |    Source   \n
 -------+----------------+----------+---------------------------------
 0x27   | PWM1 Parameter |   0x07   |  IOC  (interrupt on change)
 0x2F   | PWM2 Parameter |   0x1B   |  TMR2 (hogged for PWM)
        |                |   0x1C   |  TMR1 (wake-up from sleep)
        |                |   0x1E   |  CCP1 (Capture/Compare)
        |                |   0x1F   |  TMR0 (1 ms system clock)
        |                |   0x20   |  U1RX (UART1 RX)
\endverbatim
 */ 


void interrupt_initialize (void)
{
    INTCON0bits.IPEN = 1;   // Enable Interrupt Priority Vectors

    // Set IVTBASE (XC8 default: 0x000008)
    IVTBASEU = 0x00;
    IVTBASEH = 0x08;    // (default: 0x00, 0x08 when using BL)
    IVTBASEL = 0x08;
    
    // Assign peripheral interrupt priorities (default after reset varies!!!)
    IPR0bits.OSFIP = 1;     // OSFI  - high priority (#0x02) default
    IPR4bits.PWM1IP = 1;    // PWM1I - high priority (#0x27)
    IPR5bits.PWM2IP = 1;    // PWM2I - high priority (#0x2F)

    /* more than one interrupt with the same user specified priority level 
     * uses the natural order priority scheme, going from high-to-low with 
     * increasing vector numbers, with 0 being the highest.
     */
    IPR0bits.IOCIP  = 0;    // IOCI - low priority (#0x07)
    IPR3bits.TMR2IP = 0;    // TMR2 - low priority (#0x1B)
    IPR3bits.TMR1IP = 0;    // TMR1 - low priority (#0x1C)
    IPR3bits.CCP1IP = 0;    // CCP1 - low priority (#0x1E)
    IPR3bits.TMR0IP = 0;    // TMR0 - low priority (#0x1F)
    IPR4bits.U1TXIP = 0;    // U1RX - low priority (#0x20)
    
} // interrupt_initialize()


/** @brief  The default interrupt service routine.
 *  - Handles all unexpected interrupts.
 *  - Only action: Set error flag UNEXP_INT.
 */
void __interrupt (irq(default), base(IVT1_BASE_ADDRESS), low_priority) 
default_isr (void)
{
    g_ERRORflags.UNEXP_INT = 1;    // signal unexpected interrupt
	
} // default_isr (void)



/** @brief  Handles the PWM1 parameter interrupts. \n
 *  We use only one source of PWM1 interrupts:
 *  - on right flank of PWM1S1P2 (after settling of motor current): read Imot.
 */
void __interrupt (irq(IRQ_PWM1), base(IVT1_BASE_ADDRESS), high_priority)
PWM1_isr (void)
{
    int16_t     mAmps;
            
    // cause of interrupt: slice 1 parameter 2?
    if (PWM1GIRbits.S1P2IF)     // 2 ms after H-bridge ON
    {
        PWM1GIRbits.S1P2IF = 0; // clear interrupt flag
        
        ina219_reg(1);          // exec time ca. 49 µs (@SCL 400 kHz)
        mAmps  = ina219_read(); // exec time ca. 72 µs (@SCL 400 kHz)
        if (mAmps < 0) mAmps = 0;   // offset may cause negative readings ??

#ifdef USE_mAMP_LoPASS
        g_mAx10 += (mAmps - g_mAx10) >> NLoPASS_CURR;    // is usually > 0
#else
        g_mAx10 = mAmps;
#endif
        if(g_ns_curr < LOGSIZE)
        {
            g_curr_log[g_ns_curr++] = (uint8_t)(g_mAx10 >> 2);
        }  
#ifdef TEST_mAMPS2DAC
        DAC1DATL = (uint8_t) (g_mAx10 >> 2);    // current monitor (16 -> 8 bit)
#endif
    } // slice 1 parameter 2
    else
    {
        PWM1GIR = 0;    // unexpected interrupt - clear ALL PWM1 interrupt flags
    }

} // PWM1_isr ()


/** @brief  Handles the PWM2 parameter interrupts. \n
 *  We use only one source of PWM2 interrupts:
 *  - on right flank of PWM2S1P2 (mid of H-bridge turned off): read Back EMF.
 */
void __interrupt (irq(IRQ_PWM2), base(IVT1_BASE_ADDRESS), high_priority)
PWM2_isr (void)
{
    uint16_t    uk;
            
    // cause of interrupt: slice 1 parameter 2?
    if (PWM2GIRbits.S1P2IF)     // approx. 400 µs after H-bridge OFF
    {
        PWM2GIRbits.S1P2IF = 0; // clear interrupt flag        
        uk = daq_vbemf(g_vz);   // Exec time ca. 100 µs
        
#ifdef USE_BEMF_LoPASS
        // see: PIC datasheet 40.5.6 Low-Pass Filter Mode and microchip AN2749
        g_vbemf += (uk - g_vbemf) >> NLoPASS_BEMF;  // is usually > 0
#else
        g_vbemf = uk;
#endif
        // data logger: save g_vbemf into bemf_log[]
        if(g_ns_bemf < LOGSIZE)
        {
            g_vbemf_log[g_ns_bemf++] = (uint8_t)(g_vbemf >> 4);
        }
        
#ifdef TEST_VBEMF2DAC
        // monitor VBEMF (16 -> 8 bit) - requires DACout routed to a pin
        DAC1DATL = (uint8_t) (g_vbemf >> 4);
#endif
        // sum up speed
        if      (g_dir > 0) g_vbemf_sum[g_vz] += g_vbemf;
        else if (g_dir < 0) g_vbemf_sum[g_vz] -= g_vbemf;      
     } // slice 1 parameter 2
    else
    {
        PWM2GIR = 0;    // unexpected interrupt - clear ALL PWM2 interrupt flags
    }
   
} // PWM2_isr ()


/** @brief  Handles all IOC events. \n
 *  We currently don't use any IOC interrupt. Just reset the flags.
 */
void __interrupt (irq(IRQ_IOC), base(IVT1_BASE_ADDRESS), low_priority)
IOC_isr (void)
{
    IOCAF = IOCBF = IOCCF = 0;  // clear all IOC Flags    

} // IOC_isr()


/** @brief Timer0 interrupt (1 ms system clock and timeout).
 *  - Increments g_timer_ms (system timer)
 */
void __interrupt (irq(IRQ_TMR0), base(IVT1_BASE_ADDRESS), low_priority) 
TMR0_isr (void)
{
    PIR3bits.TMR0IF = 0;    // on entry: clear interrupt flag
    if (++g_timer_ms == 0x0000) g_tovfl_ms = true;  // > 65.535 ms elapsed
    
} // TMR0_isr()


/** @brief Timer1 interrupt.
 *  - TMR1 is used for wake-up from sleep (not yet implemented).
 */
void __interrupt (irq(IRQ_TMR1), base(IVT1_BASE_ADDRESS), low_priority) 
TMR1_isr (void)
{
    PIR3bits.TMR1IF = 0;    // on entry: clear interrupt flag
    
} // TMR1_isr()


/** @brief Timer2 interrupt.
 * - (not used yet)
 */
void __interrupt (irq(IRQ_TMR2), base(IVT1_BASE_ADDRESS), low_priority) 
TMR2_isr (void)
{
    PIR3bits.TMR2IF = 0;    // on entry: clear interrupt flag
    
} // TMR2_isr()


/** @brief  Handles UART receive events.
 *  - Interrupt when receiving data from ESP via the UART
 *  - Stores chars in g_rx232_buf[]
 *  - Sets flag g_rs232_request = 1 after detection of CR or LF.
 */
void __interrupt (irq(IRQ_U1RX), base(IVT1_BASE_ADDRESS), low_priority)
U1RX_isr (void)
{
    uint8_t  ch;    // received ascii char

    // PIR4bits.U1RXIF = 0;    // U1RXIF cannot be cleared by software

    if (U1ERRIRbits.RXFOIF || U1ERRIRbits.FERIF) 
    {   // overrun or framing error?
        U1ERRIRbits.RXFOIF = U1ERRIRbits.FERIF = 0;
        ch = U1RXB;            
        init_uart1();               // reset serial port
    }
    else 
    {  // valid char received, save to buffer, check if CR
        ch = U1RXB;
        if (ch == '\r' || ch == '\n')  
        {
            ch = 0;
            if (g_rx232_count > 1)  
            {
                g_rs232_request = 1;
                PIE4bits.U1RXIE = 0;    // disable further U1RX interrupts
            }                           // until cmd has been processed
            else    // ignore leading CRLF
            {
                goto _exit;
            }
        } // EOL received
        if (g_rx232_count < sizeof(g_rx232_buf)) 
        {
            g_rx232_buf[g_rx232_count++] = ch;    // save to buffer
        }
        else    // buffer overflow, flush RS232 buf
        {
            for (uint8_t i = 0; i < sizeof(g_rx232_buf); i++) g_rx232_buf[i] = 0;
            g_rx232_count = 0;
        }
    } // valid char    
_exit:
    NOP();

} // U1RX_isr()


// *** private function bodies

/**
 End of File
 */
