deklaus/OpenValveControl/(commit log)

2023-10-05 Add Schematics
2023-10-13 Gerber files added PCB layout added as PDF Parts renumbered README updated PCB preview added
2023-10-19 umbenannt: Hardware/top_blue.png -> Hardware/PCB_preview.png neue Datei: Photos/OLED.png
2023-10-28 neue Datei: Photos/Assembly-1.jpg neue Datei: Photos/Assembly-2.jpg neue Datei: Photos/Assembly-3.jpg neue Datei: Photos/Assembly-4.jpg
2023-10-30 neue Dateien: PIC-ValveControl/ValveControl.X/
2023-10-30 neue Datei: PIC-ValveControl/ValveControl.X/Doxyfile neues Verzeichnis: PIC-ValveControl/ValveControl.X/doxygen geändert: PIC-ValveControl/ValveControl.X/i2c.c geändert: PIC-ValveControl/ValveControl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
2023-10-30 neue Datei: PIC-ValveControl/ValveControl.X/doxygen/rtf/refman.rtf
2023-10-30 gelöscht: PIC-ValveControl/ValveControl.X/doxygen/rtf/refman.rtf
2023-10-30 geändert: PIC-ValveControl/ValveControl.X/Doxyfile
2023-11-03 neue Datei: ESP-ValveControl/DS18B20.ino
2023-11-03 geändert: ESP-ValveControl/ESP-ValveControl.ino
2023-11-07 geändert: Photos/Assembly-2.jpg
2023-11-09 geändert: PIC-ValveControl/ValveControl.X/dist/default/production/ValveControl.X.production.hex geändert: PIC-ValveControl/ValveControl.X/main.c
2023-11-12 geändert: ESP-ValveControl/ESP-ValveControl.ino neue Datei: ESP-ValveControl/LittleFS.ino geändert: ESP-ValveControl/OLED.ino geändert: ESP-ValveControl/build/esp8266.esp8266.d1_mini_clone/ESP-ValveC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
2023-11-13 geändert: ESP-ValveControl/index.html
2023-11-15 geändert: ESP-ValveControl/DS18B20.ino geändert: ESP-ValveControl/ESP-ValveControl.ino geändert: ESP-ValveControl/LittleFS.ino geändert: ESP-ValveControl/OLED.ino neue Datei: ESP-ValveControl/fs.html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
2023-11-15 geändert: ESP-ValveControl/build/esp8266.esp8266.d1_mini_clone/ESP-ValveControl.ino.bin
2023-11-24 neues Verzeichnis: PIC-ValveControl/Bootloader.X/ neue Datei: PIC-ValveControl/Hexfiles/ValveControl_v0.6.hex neue Datei: PIC-ValveControl/Hexfiles/ValveControl_v0.6.unified.hex
2023-12-15 geändert: ESP-ValveControl/ESP-ValveControl.ino geändert: ESP-ValveControl/build/esp8266.esp8266.d1_mini_clone/ESP-ValveControl.ino.bin geändert: ESP-ValveControl/index.html geändert: ESP-ValveContro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
2024-01-17 geändert: PIC-ValveControl/README.md
2024-01-17 geändert: PIC-ValveControl/ValveControl.X/daq.c
2024-01-17 change: PIC-ValveControl/ValveControl.X/daq.c update: Photos/WebUI.png
2024-01-17 geändert: PIC-ValveControl/ValveControl.X/daq.c update: Photos/WebUI.png
2024-01-17 geändert: PIC-ValveControl/ValveControl.X/doxygen/
2024-01-20 geändert: PIC-ValveControl/ValveControl.X/Doxyfile geändert: PIC-ValveControl/ValveControl.X/dist/default/production/ValveControl.X.production.hex geändert: PIC-ValveControl/ValveControl.X/dist/defau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
2024-01-24 geändert: ESP-ValveControl/ESP-ValveControl.ino geändert: ESP-ValveControl/build/esp8266.esp8266.d1_mini_clone/ESP-ValveControl.ino.bin neue Datei: ESP-ValveControl/customize.js geändert: ESP-ValveCo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
2024-01-24 umbenannt: ESP-ValveControl/build/esp8266.esp8266.d1_mini_clone/ESP-ValveControl.ino.bin
2024-01-24 neue Datei: ESP-ValveControl/build/esp8266.esp8266.d1_mini_clone/ESP-ValveControl-v0.7.bin
2024-01-24 gelöscht: ESP-ValveControl/build/esp8266.esp8266.d1_mini_clone/ESP-ValveControl-v0.7.bin
2024-01-25 neue Datei: PIC-ValveControl/Hexfiles/ValveControl_v0.7.hex neue Datei: PIC-ValveControl/Hexfiles/ValveControl_v0.7.unified.hex geändert: PIC-ValveControl/ValveControl.X/doxygen/html/ geändert: PIC-V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
2024-01-29 geändert: ESP-ValveControl/ESP-ValveControl.ino neu: ESP-ValveControl/build/esp8266.esp8266.d1_mini_clone/ESP-ValveControl_v0.7.1.bin geändert: ESP-ValveControl/webUI.ino geändert: PIC-ValveControl/B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
2024-02-13 update: Documentation/User Manual v0.2.1.pdf -> Documentation/User Manual v0.2.2.pdf geändert: PIC-ValveControl/Bootloader.X/main.c geändert: PIC-ValveControl/ValveControl.X/i2c.c geändert: PIC-Valve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
2024-03-13 geändert: PIC-ValveControl/ValveControl.X/Doxyfile update: PIC-ValveControl/ValveControl.X/doxygen/html/ geändert: PIC-ValveControl/ValveControl.X/interrupt.c geändert: PIC-ValveControl/ValveControl.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
2024-03-13 neue Datei: PIC-ValveControl/Hexfiles/ValveControl.X_v0.8.hex neue Datei: PIC-ValveControl/Hexfiles/ValveControl.X_v0.8.unified.hex
2024-03-13 geändert: ESP-ValveControl/ESP-ValveControl.ino geändert: ESP-ValveControl/webUI.ino
2024-03-15 Update: Documentation/User Manual v0.4.pdf -> Documentation/User Manual v0.4.1.pdf Rename: PIC-ValveControl/Hexfiles/ValveControl_v0.8.hex Rename: PIC-ValveControl/Hexfiles/ValveControl_v0.8.unified.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
2024-03-15 rename: PIC-ValveControl/Hexfiles/ValveControl.X_v0.8.hex -> PIC-ValveControl/Hexfiles/ValveControl_v0.8.hex rename: PIC-ValveControl/Hexfiles/ValveControl.X_v0.8.unified.hex -> PIC-ValveControl/Hexf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
2024-03-23 Update: Hardware/Gerber/ovc_A.zip Update: Hardware/OpenValveControl_RevA_Board.pdf Update: Hardware/OpenValveControl_RevA_Placeplan.pdf Update: Hardware/OpenValveControl_RevA_Schematics.pdf Update: H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
2024-03-23 geändert: PIC-ValveControl/ValveControl.X/Doxyfile geändert: PIC-ValveControl/ValveControl.X/doxygen/html/ geändert: PIC-ValveControl/ValveControl.X/init.c geändert: PIC-ValveControl/ValveControl.X/i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
2024-03-23 neue Datei: PIC-ValveControl/Hexfiles/ValveControl_v0.8.1.hex neue Datei: PIC-ValveControl/Hexfiles/ValveControl_v0.8.1.unified.hex
2024-03-23 gelöscht: PIC-ValveControl/Hexfiles/obsolete/
2024-04-19 Update: Documentation/User Manual v0.4.1.pdf -> Documentation/User Manual v0.5.pdf neue Datei: PIC-ValveControl/Hexfiles/ValveControl_v0.8.2.hex neue Datei: PIC-ValveControl/Hexfiles/ValveControl_v0.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
2024-10-27 geändert: ESP-ValveControl/ESP-ValveControl.ino geändert: ESP-ValveControl/LittleFS.ino neue Datei: ESP-ValveControl/build/esp8266.esp8266.d1_mini_clone/ESP-ValveControl_v0.9.bin geändert: ESP-ValveC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
2024-10-28 geändert: PIC-ValveControl/ValveControl.X/Doxyfile update: PIC-ValveControl/ValveControl.X/doxygen/
